Hom-Wang/Quadcopter/Readme.md

Quadcopter
========
* Author      : [Hom](https://github.com/Hom19910422)
* Update      : 2013/12/07
* Description :   
101年的大學專題，專題成果大致可以達到平衡(不太穩)，但尚無法懸停，  
需要更新、更穩定的飛控版本請到 [QCopterFC](https://github.com/Hom19910422/QCopterFlightControl) 下載，這裡將不再做更新。

飛控板
========
* 控制器　STM32F405RG 64Pin 168MHz DSP FPU
* 感測器　L3G4200 + LSM303
* 無線傳輸　nRF24L01P + PA + LNA
* 6個PWM通道　連接電調、LED、PPM
* 1個UART接口　可擴充GPS模組、藍芽模組、電腦傳輸RS232

遙控器
========
* 控制器　STM32F407VG 100Pin 168MHz DSP FPU
* 顯示器　4.3吋螢幕，480*242，SSD1963
* 無線傳輸　nRF24L01P + PA + LNA
* 儲存紀錄　SD卡，使用SDIO操作
* 1個I2C接口　外擴其他裝置
* 1個UART接口　可擴充GPS模組、藍芽模組、電腦傳輸RS232
* DEMO Videos https://www.youtube.com/watch?v=KsObp2a2QdA
<p>
<br />
四軸飛行器<br />

<br /><br />
飛控板<br />

<br /><br />
遙控器正面<br />

<br /><br />
遙控器背面<br />

<br /><br />
螢幕主畫面<br />

<br /><br />
螢幕示波器<br />

<br /><br />
螢幕測試<br />

<br /><br />
<p/>
<br /><span xmlns:dct="http://purl.org/dc/terms/" property="dct:title">Quadcopter</span>由<a xmlns:cc="http://creativecommons.org/ns#" href="https://plus.google.com/u/0/112822505513154783828/posts" property="cc:attributionName" rel="cc:attributionURL">Hom</a>製作，以<a rel="license" href="http://creativecommons.org/licenses/by-sa/3.0/tw/deed.zh_TW">創用CC 姓名標示-相同方式分享 3.0 台灣 授權條款</a>釋出。
