Hom-Wang/Quadcopter/STM32F4_QCopter_20130617/Project_SlaveV2/Readme.txt

/*=====================================================================================================*/
/*=====================================================================================================**
* File Name   : Readme.txt
* Author      : Hom19910422
* Version     : V1.0
* Date        : 2012/09/11
* Description : QCopter Fly Board Software/Hardware Information
**=====================================================================================================*/
/*=====================================================================================================**
* Hardware
*	MCU       : STM32F405VGT
*	SENSOR    : L3G4200, LSM303, BMP085
*	RF        : nRF24L01P+PA+LNA
*	LED       : 8*LED
*	KEY       : 1*SmallButton
*	
*	Add       : uBlox NEO-6M, Bluetooth, OV7670
**=====================================================================================================*/
/*=====================================================================================================**
* Pin Assign
*	PA0		PWM5					*	PB0		PWM3					*	PC0		OV7670_D0
*	PA1		PWM6					*	PB1		PWM4					*	PC1		OV7670_D1
*	PA2		LED6					*	PB2		BOOT_BOOT1				*	PC2		OV7670_D2
*	PA3		LED8					*	PB3		JTAG_JTDO				*	PC3		OV7670_D3
*	PA4		LED3					*	PB4		JTAG_NJTRST				*	PC4		OV7670_D4
*	PA5		KEY						*	PB5		LED4					*	PC5		OV7670_D5
*	PA6		PWM1					*	PB6		I2C1_SCL				*	PC6		OV7670_D6
*	PA7		PWM2					*	PB7		I2C1_SDA				*	PC7		OV7670_D7
*	PA8		LED1					*	PB8		LED7					*	PC8		OV7670_SCL
*	PA9		USART1_Tx				*	PB9		LED5					*	PC9		OV7670_SDA
*	PA10	USART1_Rx				*	PB10	USART3_Tx				*	PC10	OV7670_VSYN
*	PA11	NRF_CE					*	PB11	USART3_Rx				*	PC11	OV7670_WRST
*	PA12	NRF_IRQ					*	PB12	NRF_CSN					*	PC12	OV7670_WEN
*	PA13	JTAG_JTMS				*	PB13	NRF_SCL					*	PC13	OV7670_RRST
*	PA14	JTAG_JTCK				*	PB14	NRF_MISO				*	PC14	OV7670_CS
*	PA15	JTAG_JTDI				*	PB15	NRF_MOSI				*	PC15	OV7670_WR

*	PD2		LED2
**=====================================================================================================*/
/*=====================================================================================================**
* Function : 
*	
**=====================================================================================================*/
/*=====================================================================================================*/
