Hom-Wang/Quadcopter/無人飛行載具_四軸飛行器.pdf

## 無人飛行載具 - 四軸飛行器

王文宏 Wang, Wen-Hung
Hom19910422@gmail.com

摘要－
本專題的主要目的為在單晶片上建立一個可測得載體
當下姿態角度的姿態系統，並通過PD控制器在四軸飛行器 上實現自主平衡與懸停的功能，並藉由自製的平台來做調
整及控制。
專題進行過程首先了解四軸飛行器的結構組成及飛行
原理，再對無線傳輸模組及無刷馬達做控制，以及感測器
讀取與濾波，最後計算飛行器姿態與自主平衡控制。

關鍵字：四軸飛行器、姿態系統、四元數、PID。

1、簡介
近 年 來 ， 由於微機電系統技術 （ Micro Electro Mechanical Systems，MEMS）快速發展與半導體製程工藝 的提升，造就了低成本、普及的感測器，以及高效能的微
控制器，使的以演算法與感測器為核心的四軸飛行器成為
熱門的研究課題，其有重量輕、體積小、結構簡單、機動
性高、維護方便等優點，基於以上優點，可以應用於實時
的監控、地形的探勘、災區的救援以及搜尋、運送等領域
[1]。
目前國內成功大學航太所的飛行控制與模擬實驗室，
研究無人飛行器載具的導航與控制已有數年，並有不錯的
成果，國外美國賓州大學（University of Pennsylvania） GRASP實驗室（The General Robotics, Automation, Sensing and Perception）研究飛行器與飛行器間的協同工作，以及 瑞士蘇黎世聯邦理工學院（ETH Zurich）動態系統與控制研 究所（Institute for Dynamic Systems and Control）的FMA實 驗室（Flying Machine Arena）研究飛行器的學習和安全性， 在學術及實際應用上都有重大的貢獻。

2、結構與飛行原理

2.1、飛行器結構
四軸飛行器結構如圖 1 所示，由兩對正反螺旋槳、四
顆無刷馬達、四個電子調速器（電調）、一顆鋰電池與一片 飛行控制板（飛控板）所組成。

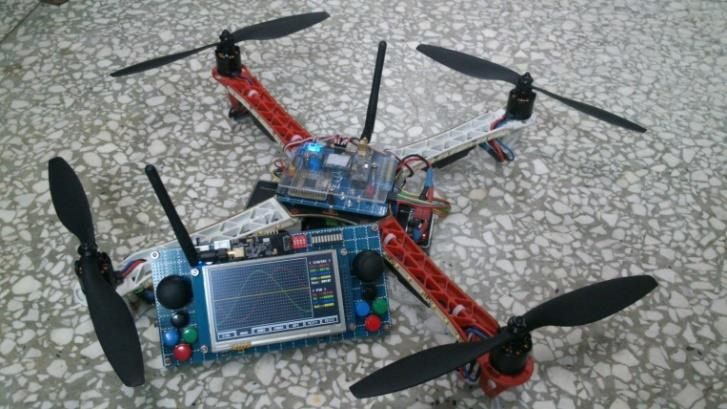
[picture p1: figure]

圖 1 四軸飛行器實體圖
2.1.1、機身
用來放置控制器、馬達、電池以及擴充裝置 … 等等
的平台。機身的大小，會限制螺旋槳的長度，進而影響到
馬達的選擇、飛行器的負載；機身的硬度、材質，會改變
到馬達所產生震動影響的大小。本次專題使用對角馬達與
馬達距離為 450mm 的機身。

2.1.2、螺旋槳
經由馬達帶動旋轉來產生推力以提供飛行器向上升力。
其中螺旋槳依擺放位置分成兩組，兩組旋轉方向互為相反， 達到水平的旋轉力矩平衡。在相同轉速下，螺旋槳越長，
攻角越大，所提供的升力就越大，但所受到的阻力亦會越
大，所以轉動大的螺旋槳需要扭力大的馬達。本次專題使
用 1045 的螺旋槳（長 10cm, 螺距 45），如圖 2 所示。

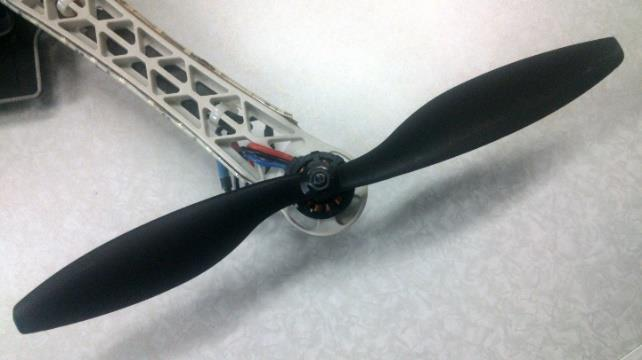
[picture p2: figure]

圖 2 螺旋槳實體圖

2.1.3、無刷馬達
旋轉螺旋槳主要的動力來源，推動飛行器。與有刷馬
達相比，無刷馬達具有扭力大、低耗損的優點，但由於其
結構設計的問題，必須加上一些電路與較為複雜的方法解
決換相問題；線圈的匝數、繞線圈的方法與供電電壓，會
影響到馬達的扭力與轉速，匝數越多間接導致扭力越大、
轉速越低；匝數越少，扭力越小、轉速越快。本次專題使
用 980KV 的無刷馬達（980RPM/V），如圖 3 所示。

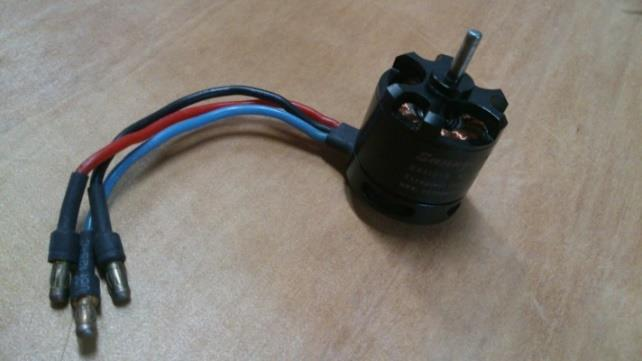
[picture p3: figure]

圖 3 無刷馬達實體圖

2.1.4、電子調速器
藉由此裝置可以簡化無刷馬達的控制，這裡簡稱電調。
電調內已放置了驅動電路與無刷馬達控制程式，只需透過
脈衝寬度調變技術（Pulse Width Modulation, PWM）即可控 制無刷馬達。本次專題使用 40A 的電調，如圖 4 所示。

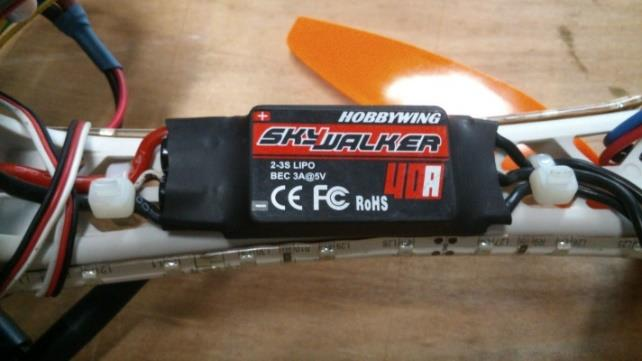
[picture p4: figure]

圖 4 電子調速器實體圖

2.1.5、電池
提供控制板與馬達電源。本專題使用 11.1V 2200mAh 的鋰電池（最大放電 25C, 瞬間 35C），如圖 5 所示。

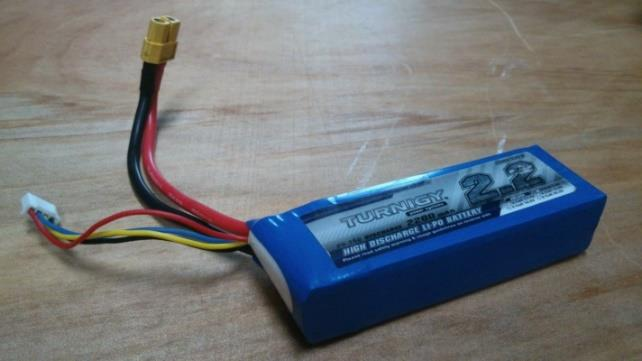
[picture p5: figure]

圖 5 鋰電池實體圖

2.1.6、飛行控制器
控制飛行器平衡運動與傳輸的裝置，這裡簡稱飛控板。
飛控板是集成微控制器、感測器、無線傳輸模組的裝置，
也是非行器的核心裝置，圖 6 為自行設計和製作的飛控版 QCopterFlightControl[2]，以下為配置：
- 微控制器 STM32F405RG
- ARM 32bit Cortex-M4 CPU with FPU
- Frequency up to 168MHz
- 196Kbytes SRAM，1024bytes Flash
- 感測器 SmartIMU[3]
- ARM 32bit Cortex-M4 CPU with FPU
- MPU9250 加速度計、陀螺儀、電子羅盤
- MS5611 氣壓計
- 無線傳輸 nRF24L01P + PA + LNA
- 理想傳輸距離 520m（2Mbps）、750m（1Mbps）、 1000m（250Kbps）
- 儲存紀錄 Micro SD
- SDIO 讀寫
- 其他擴充介面
- 1*USART、1*SPI、2*ADC、1*USB、 1*CAN BUS、8*PWM

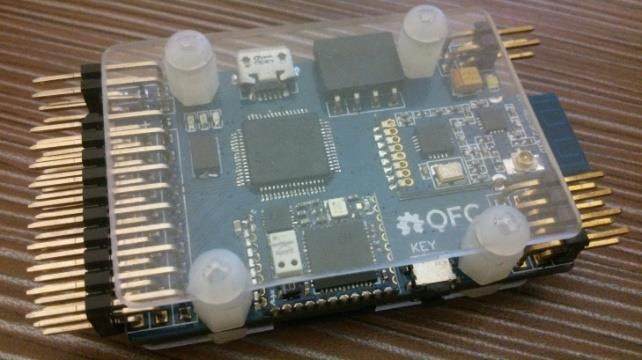
[picture p6: figure]

圖 6 飛行控制器實體圖

2.1.7、遙控器
遙控飛行器、給予飛行器指令與監控訊息的裝置。設
有飛行器基本資訊、示波器和測試 … 等介面，可以檢測 和監控飛行器狀態資訊，如圖 7 為自行設計和製作的遙控 版 QCopterRemoteControl[4]，以下為配置：
- 微控制器 STM32F407VG
- ARM 32bit Cortex-M4 CPU with FPU
- Frequency up to 168MHz
- 196Kbytes SRAM，1024bytes Flash
- 無線傳輸 nRF24L01P + PA + LNA
- 理想傳輸距離 520m（2Mbps）、750m（1Mbps）、 1000m（250Kbps）
- 顯示器 TFT_3.5-inch[5]
- 控制器 R61581
- 3.5 吋螢幕，解析度 480*320
- 色彩 16-bit（RGB 565）
- 儲存紀錄 Micro SD
- SDIO 讀寫
- 其他擴充介面
- 1*USART、1*SPI、1*USB、1*I
2C / CAN BUS

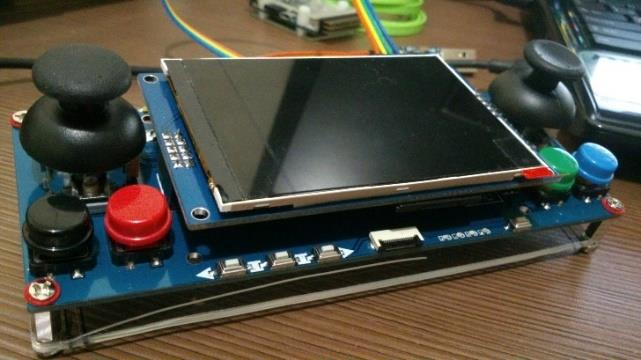
[picture p7: figure]

圖 7 遙控器實體圖

2.2、飛行原理
四軸飛行器的運動原理如圖 8 所示，當升力等於四軸
飛行器自身重量時，飛行器就會保持懸停狀態；在懸停狀
態下增加或減少相鄰兩邊馬達的旋轉速度，則會使四軸飛
行器傾斜，達到移動；若分別增加與減少對角馬達轉速，
則可使飛行器自旋。

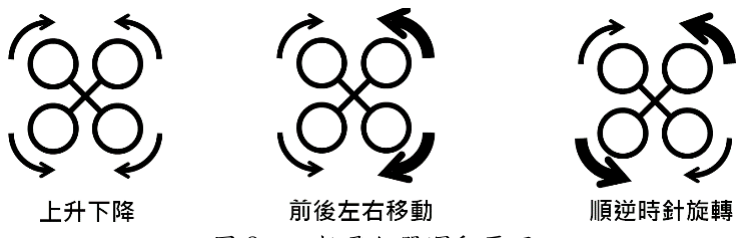
[picture p8: figure]

圖 8 四軸飛行器運動原理

3、系統架構
四軸飛行器的系統運作示意圖如圖 9 所示，微控制器
從感測器讀取資訊，透過演算法計算出飛行器當下姿態角
度作為控制器的回授，姿態角度會經由無線傳輸模組發送
至控制平台做顯示，控制平台則會傳送飛行控制命令資訊
給飛行器，飛行器上的微控制器依此控制命令與飛行器當
下姿態角度的回授，輸入到控制器做計算，控制器輸出
PWM 訊號控制電調，改變無刷馬達轉速，來達到自主平衡 與方向控制。

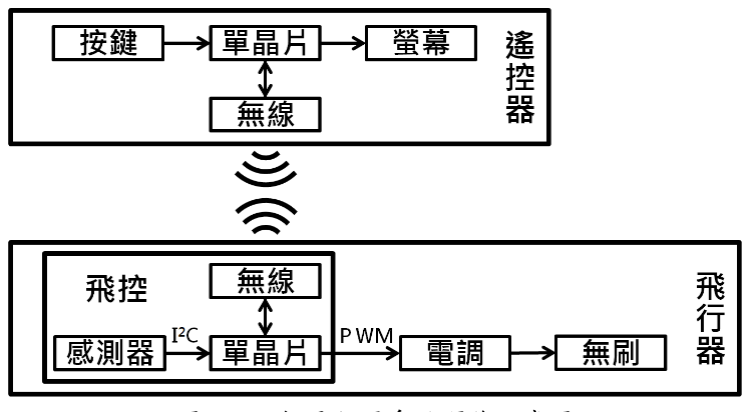
[picture p9: figure]

圖 9 四軸飛行器系統運作示意圖

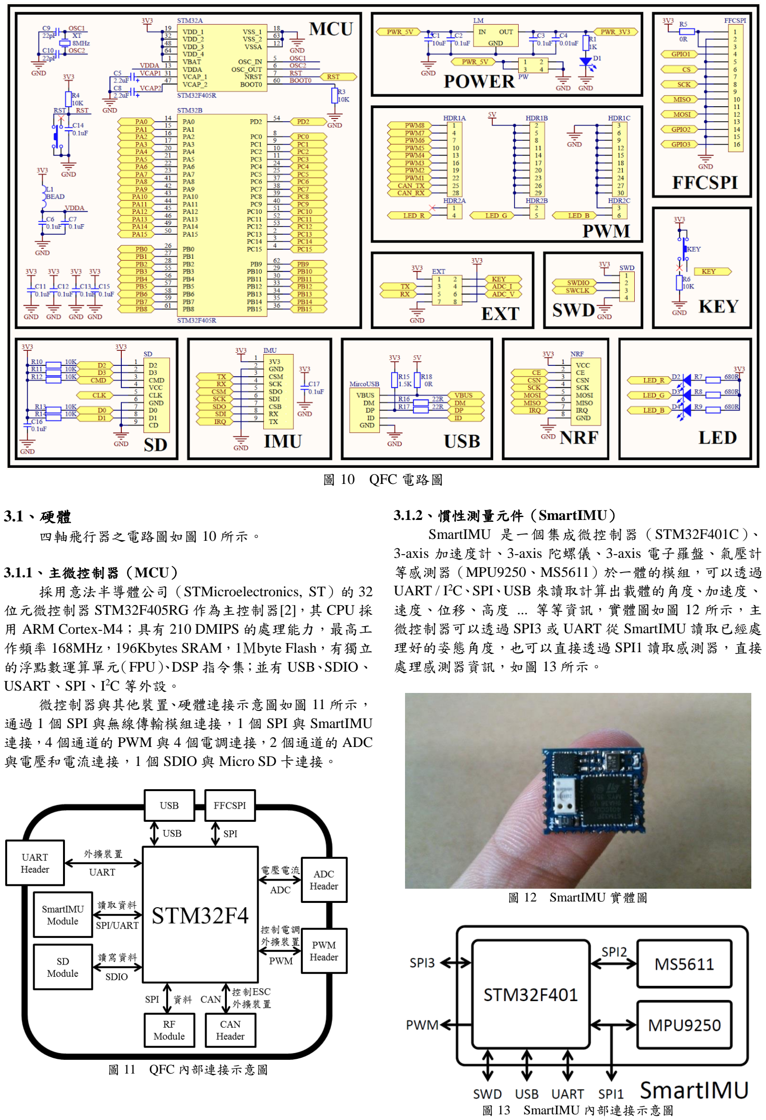
[picture p10: page 3]

圖 10 QFC 電路圖

3.1、硬體
四軸飛行器之電路圖如圖 10 所示。

3.1.1、主微控制器（MCU）
採用意法半導體公司（STMicroelectronics, ST）的 32 位元微控制器 STM32F405RG 作為主控制器[2]，其 CPU 採 用 ARM Cortex-M4；具有 210 DMIPS 的處理能力，最高工 作頻率 168MHz，196Kbytes SRAM，1Ｍbyte Flash，有獨立 的浮點數運算單元（FPU）、DSP 指令集；並有 USB、SDIO、 USART、SPI、I

2C 等外設。
微控制器與其他裝置、硬體連接示意圖如圖 11 所示， 通過 1 個 SPI 與無線傳輸模組連接，1 個 SPI 與 SmartIMU 連接，4 個通道的 PWM 與 4 個電調連接，2 個通道的 ADC 與電壓和電流連接，1 個 SDIO 與 Micro SD 卡連接。

圖 11 QFC 內部連接示意圖

3.1.2、慣性測量元件（SmartIMU）
SmartIMU 是一個集成微控制器（STM32F401C）、 3-axis 加速度計、3-axis 陀螺儀、3-axis 電子羅盤、氣壓計 等感測器（MPU9250、MS5611）於一體的模組，可以透過 UART / I

2C、SPI、USB 來讀取計算出載體的角度、加速度、 速度、位移、高度 ... 等等資訊，實體圖如圖 12 所示，主 微控制器可以透過 SPI3 或 UART 從 SmartIMU 讀取已經處 理好的姿態角度，也可以直接透過 SPI1 讀取感測器，直接 處理感測器資訊，如圖 13 所示。

圖 12 SmartIMU 實體圖

圖 13 SmartIMU 內部連接示意圖

3.1.3、無線傳輸
無線傳輸模組用於向監控平台傳送飛行器上的資訊與
接收控制平台所發送的控制訊號、指令。
本次專題所採用的無線傳輸模組使用 NORDIC 公司 2.4G 的 nRF24L01P，並搭配功率放大器（PA）與低噪音放 大器（LNA）來增加傳輸距離。nRF24L01P 提供了三種傳 輸速率 2Mbps、1Mbps、250Kbps，其空曠下傳輸距離分別 為 520m、750m、1000m。

3.1.4、電源
四軸飛行器的電源供應如圖 14 所示，由 11.1v 2200mAh 的鋰電池作為電力的來源，11.1v 經過 LM2596 轉 換成 5v，再經由 AMS1117 轉換為 3.3v，其中 11.1v 供電給 電調與無刷馬達，5v 供電給其他設備，3.3v 供電給飛控板。

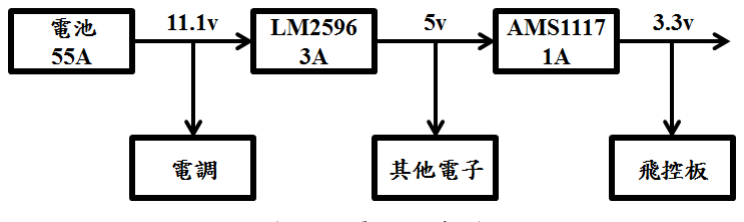
[picture p11: figure]

圖 14 電源供應圖

3.2、軟體
四軸飛行器的程式流程如圖 15 所示，供電後系統首先 對系統時脈、I/O 與各種模組及功能做初始化，再對感測器 做初始校正與飛行器姿態的初始化，最後為防止馬達突然
啟動，設置了鎖定功能，在解鎖前，接收任何訊號皆不會
使馬達旋轉。
解鎖完後即進入有限狀態機（Finite State Machine, FSM），狀態機的狀態如圖 16 所示，狀態機的初始狀態為 接收模式，在此狀態中會接收遙控器的控制訊號，接收成
功後才會進入到下一個狀態發射模式，在發射模式中會將
感測器讀到的資料與計算的姿態傳送到遙控器顯示，傳送
完後就進入下一個狀態控制模式，在控制模式中會使用平
台所傳來的控制資訊，對四軸飛行器做控制，目前只有控
制飛行器的傾斜角度與馬達轉速大小，控制完後就進入串
列模式，這個狀態是用來測試與外接其他功能用的，以增
加擴充性。

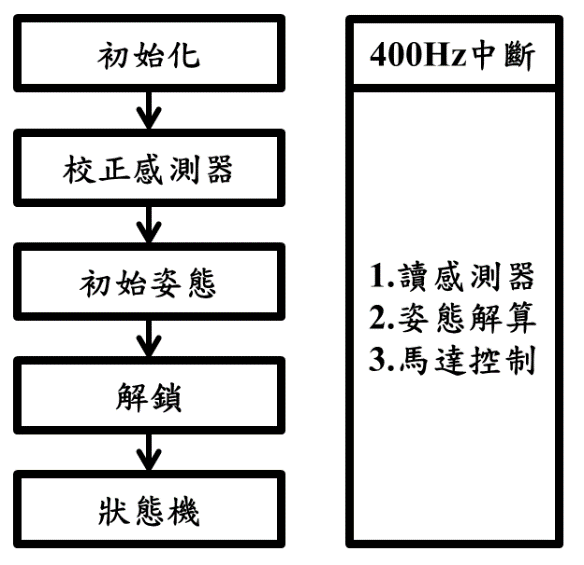
[picture p12: figure]

圖 15 程式流程圖

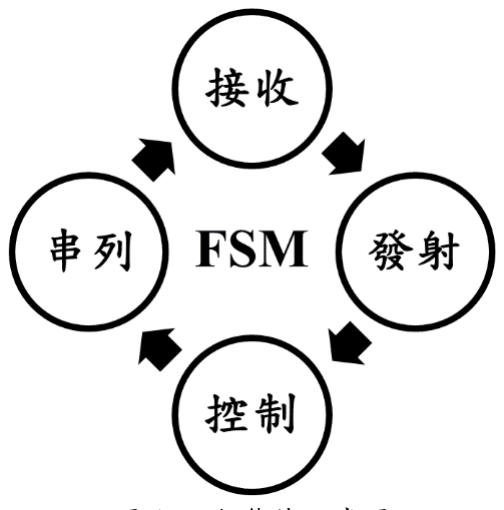
[picture p13: figure]

圖 16 狀態機示意圖

4、演算法
演算法為四軸飛行器之核心，其中主要包含了感測器
的校正、姿態的計算與平衡的控制，本次專題中主要的演
算法實現於 400Hz 的計時中斷中，其流程如圖 17 所示。 一開始先讀取感測器資料，然後利用初始校正所得到
的校正資訊對讀到的資料作校正，校正完後轉成物理量（mg、 dps、gauss），再對其做加權移動平均，減少誤差，最後計 算飛行器姿態，並依此當前的姿態做 PID 平衡，以達到自 主懸停及控制。

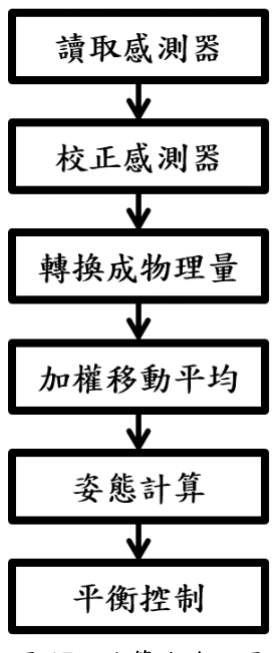
[picture p14: figure]

圖 17 演算法流程圖

4.1、初始校正
MEMS 元件雖然具有體積小與低成本的優勢，但只要
是感測器都會有誤差存在的問題。

4.1.1、加速度計校正
考慮到地球上相同地區的重力加速度誤差可視為零的
情況下，預先測量在水平狀態下的加速度與重力加速度
g (0, 1, 1) 的誤差並記錄，在程式中就不需再次測量，直接 對加速度計誤差的做偏移校正。

4.1.2、陀螺儀校正
陀螺儀為測量角速度的元件，已知靜止無運動的情況
下，角速度為零，利用此條件對陀螺儀做校正，實際方法： 先讓飛行器保持靜止，此時讀取陀螺儀 100 筆數據求平均 值，此平均值則為陀螺儀的誤差偏移量，之後每次讀取完
後減去此平均值即可得到正確的數據。

4.1.3、電子羅盤校正
地球磁場並非是均勻分佈的，會存在磁傾角及磁偏角，
以台灣為例，磁傾角約為 37 度左右，加上馬達、環境、電 池…等的影響干擾，在不校正的情況下，難以取的正確的
航向。
只考慮二維的情況下，電子羅盤的 X 軸 Y 軸所讀到的 磁場理想上會以中心在原點上的圓形所分佈，但受到其他
磁場的影響會使圓形變形且偏離原心，造成磁場以橢圓形
分佈。
對電子羅盤間隔 45 度做一次取樣，共有 8 點的磁場樣 本，在對樣本做橢圓擬合[5]，得出橢圓方程後，將橢圓移 到原心，並還原成圓形，使航向可以正常取得，詳細過程
請參考附件 1。

4.2、姿態計算
直接對角速度做積分是取得姿態的方法之一，但由於
陀螺儀本身的誤差會隨溫度變化，長時間對角速度做積分
等同於放大誤差，加上角速度所計算出來的角度其中有一
為 90 度或 270 度時，轉回原始座標時就會產生萬向節鎖 （Gimbal Lock）的問題，導致轉不回去，所以專題在姿態 計算中採用四元數[6]，並使用文獻[7]的方法實現。 在航向角部分採用互補濾波（Complementary Filter, CF），依文獻[8]之方法，套用至基於電子羅盤的航向角確定， 將電子羅盤靜態時精確及陀螺儀的高靈敏度的特性結合在
一起，以取得準確的航向。

4.2.1、四元數
四元數可以有效解決萬向節鎖問題，且經過一些變換
後，可以直接以角速度來更新姿態與使用加速度計來校正
陀螺儀。
利用四元數將地理的重力加速度旋轉至飛行器上面，
再與加速度計讀出的值（已歸一化的）做外積，得出誤差， 用此誤差對角速度做校正融合，詳細過程請參考附件 2。

4.2.2、互補濾波
將電子羅盤長期準確及陀螺儀靈敏度高的特性互補，
即為對電子羅盤做低通濾波，對陀螺儀做高通濾波，並將
其相加，得出較為可信的資訊。

Angle = (k) ∗ (Angle + Gyro ∗ dt) +(1 −k) ∗ AngleMag

其中k 是高低通頻率邊界，k = 時間常數 τ/(時間常數 τ+ 取樣時間 dt)，AngleMag 是透過電子羅盤計算出來的航向 角度。

4.3、平衡控制
PID 控制器在控制領域上已有數十年的發展，其特點
簡單、穩定和有效，使他至今仍然廣為使用，本專題在自
主平衡方面選用 PD 控制器，輸入期望角度及當前三軸角度 以及角速度至 PD 控制器，將計算出來的三軸結果，依螺旋 槳旋轉的方向分配至四顆馬達上，來達到對四軸平衡的效
果，控制器設計如下：

u(t) = KP ∗ e(t) + KD ∗ ω(t)

上式中 u(t) 是 PD 控制器的輸出，KP 與 KD 是控制器參 數，e(t) 是回授角度與期望角度的誤差，ω(t) 是角速度。

5、結果與討論
以 400Hz 的取樣及更新週期，在沒有啟動馬達的情況 下，姿態角的誤差可以達到 0.2 度以內，在起動馬達後，因 為馬達的震動，使角度會在 5 度內震盪，使用 PID 控制器 雖然可以讓飛行器飛起來，但卻沒辦法非常穩定的平衡，
所以目前設計的計算姿態方法還需再調整及改善，以達到
穩定的平衡，圖 18 至圖 25 為起飛時每隔 0.2 秒所拍攝的實 際影像。
圖26為加速度的整體數據，縱軸單位為加速度（mg）， 橫軸單位為數據數，啟動馬達後加速度計的XY軸約在±0.3g 跳動，而 Z 軸約±0.2g 跳動。
圖 27 為陀螺儀的整體數據，縱軸單位為角速度
（10mdps），橫軸單位為數據數，啟動馬達後陀螺儀的 X 軸 約±40dps 跳動，Y 軸約±100dps 跳動，而 Z 軸約±10dps 跳 動。
圖 28 為電子羅盤的整體數據，縱軸單位為高斯
（0.1mGauss），橫軸單位為數據數，啟動馬達後電子羅盤 震動都還不算太大，但出現了明顯的磁場變化，X 軸約減 少了 20mGauss，Y 軸約減少了 60mGauss，而 Z 軸約減少 了 70mGauss。
圖 29 為計算出來的角度數據，縱軸單位為角度（XY 軸 10mdeg，Z 軸 100mdeg），橫軸單位為數據數，啟動馬達 後角度的 X 軸約±4deg 跳動，Y 軸約±2deg 跳動，而 Z 軸幾 乎沒有明顯震動，反倒是偏移了 10deg。

6、參考文獻
[1] 維基百科，四軸飛行器
http://zh.wikipedia.org/wiki/%E5%9B%9B%E8%BD%B 4%E9%A3%9E%E8%A1%8C%E5%99%A8 (http://zh.wikipedia.org/wiki/%E5%9B%9B%E8%BD%B4%E9%A3%9E%E8%A1%8C%E5%99%A8)
[2] QCopterFlightControl, GitHub https://github.com/QCopter/QCopterFlightControl
[3] SmartIMU, GitHub
https://github.com/Hom-Wang/SmartIMU
[4] QCopterRemoteControl, GitHub https://github.com/QCopter/QCopterRemoteControl
[5] 陳基偉，橢圓直接擬合算法研究，工程勘察，2007
[6] 鄭正隆，慣性技術 Inertial Technology，崧博出版事業 有限公司，2011
[7] M. Euston, P. Coote, R. Mahony, Jonghyuk Kim and T. Hamel, “A Complementary Filter for Attitude Estimation of a Fixed-Wing UAV,” IEEE International Conference on Intelligent Robots and Systems, pp. 340-345, Sept. 2008.
[8] Shane Colton, “The Balance Filter,” Massachusetts Institute of Technology, Tech. Rep., 2007

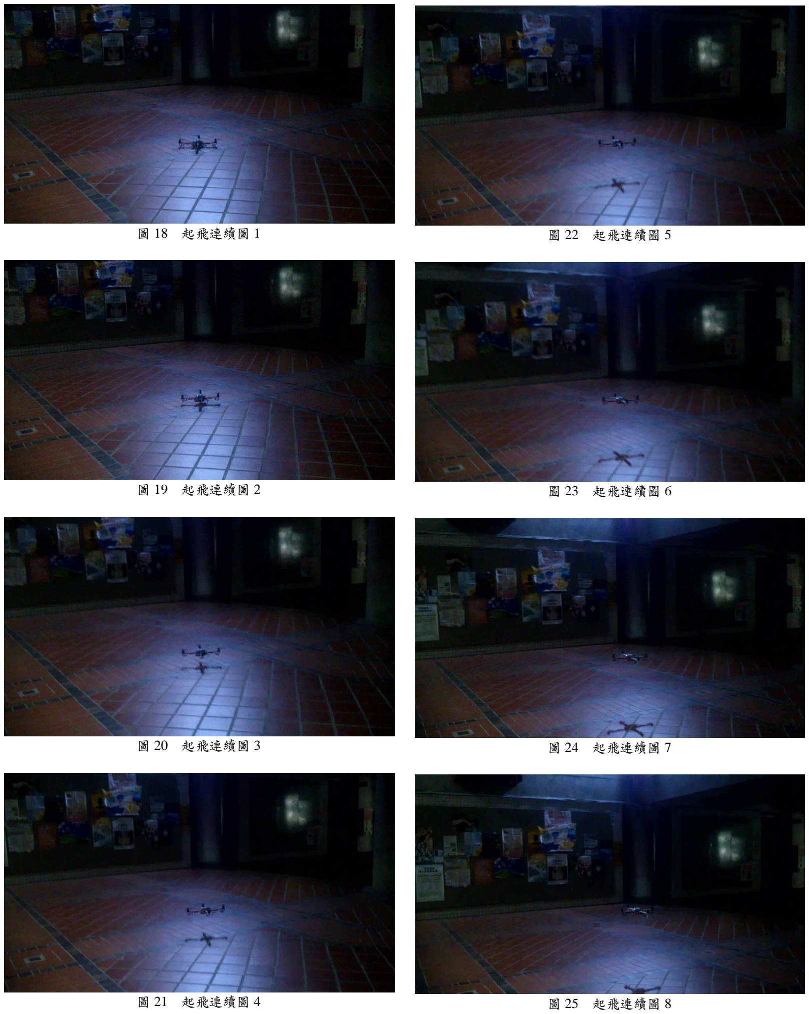
[picture p15: page 6]

圖 18 起飛連續圖 1

圖 19 起飛連續圖 2

圖 20 起飛連續圖 3

圖 21 起飛連續圖 4

圖 22 起飛連續圖 5

圖 23 起飛連續圖 6

圖 24 起飛連續圖 7

圖 25 起飛連續圖 8

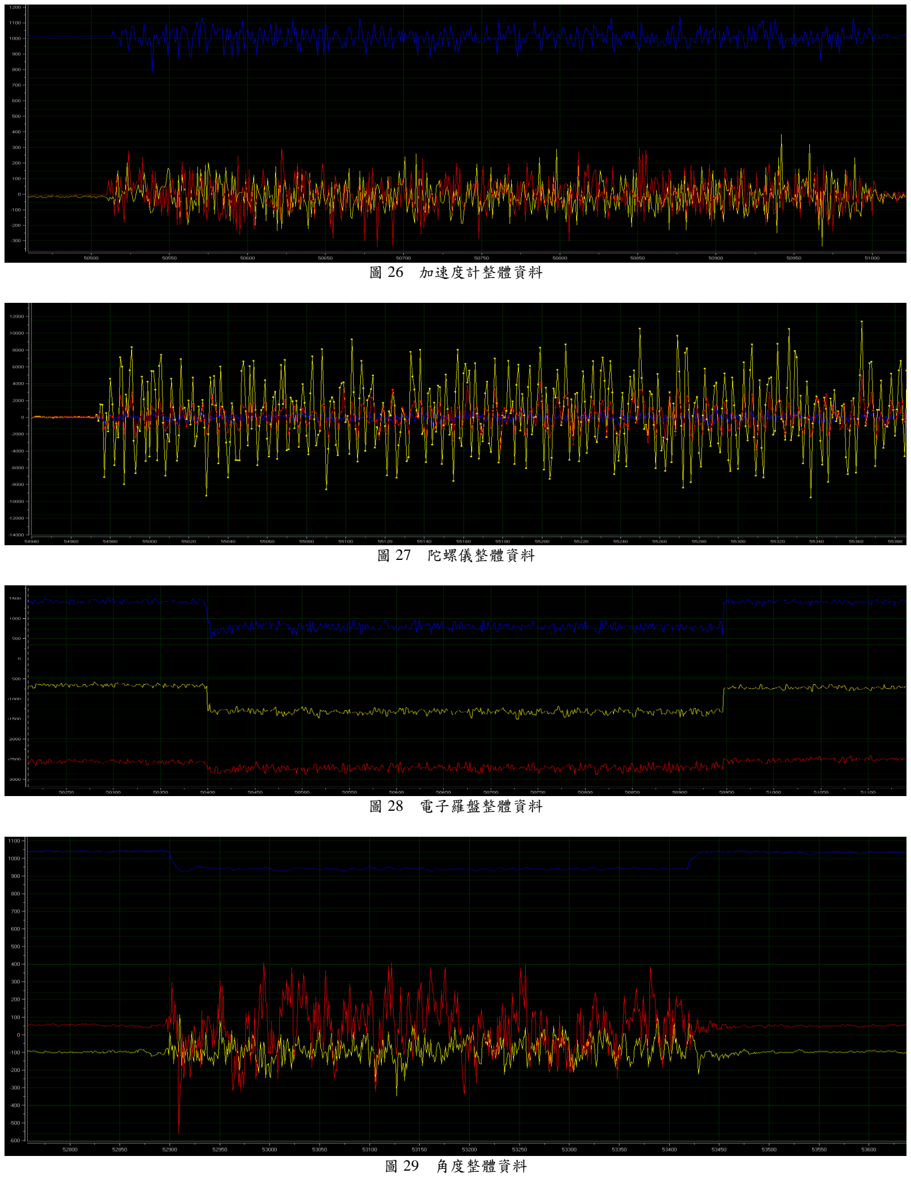
[picture p16: page 7]

圖 26 加速度計整體資料

圖 27 陀螺儀整體資料

圖 28 電子羅盤整體資料

圖 29 角度整體資料

附件 1、橢圓擬合

任意位置大小的橢圓方程式可以描述如下：
(

X −X0
a

)

2
+(

Y − Y0
b

)

2
= 1

上式可分解成圓形對 X, Y 軸做變形
{

(

X − X0
Y − Y0

) = (

a 0
0 b

) (

X′
Y′

)

(X′)

2 +(Y′)

2 = 1

對 X, Y 軸做旋轉
{

(

X −X0
Y −Y0

) = (

cosθ sinθ
−sinθ cosθ

) (

a 0
0 b

) (

X′
Y′

)

(X′)

2 +(Y′)

| 2 = 1

求得 X

′
, Y′
(

X

′
Y

′

) = (

a ∗ cosθ b ∗ sinθ
−a ∗ sinθ b ∗ cosθ)

−1
(

X − X0
Y − Y0

)

⟹ (

X

′
Y

′

) = (

cosθ
a

−

cosθ
a

·

sinθ
Cos[θ]
cosθ
b

·

sinθ
cosθ

cosθ
b

) (
X − X0
Y − Y0

)

令 α =

cosθ
a

, β =

cosθ
b

, γ = tanθ

⟹ (

X

′
Y

′

) = (

α | −α · γ
β · γ | β

) (

X − X0
Y − Y0

) = (

α(X −X0

)− αγ(Y − Y0)
βγ(X − X0

)+ β(Y − Y0)

)

代入圓形方程&整理

(α(X − X0

)− αγ(Y − Y0

))

2 + (βγ(X − X0
)+β(Y − Y0

))

2 = 1

⟹ (α

2 + β

2γ

2
)(X − X0

)

2 +2(β

2γ − α

2γ)(X −X0
)(Y −Y0

)+ (α

2γ

2 + β

2
)(Y − Y0

)

2 = 1

令 U = α

2 + β

2γ

2
, V = 2(β

2γ − α

2γ), W = α

2γ

2 + β

2

(U)X

2 + (V)XY + (W)Y

2 + (−2UX0 −VY0
)X + (−VX0 − 2WY0

)Y +(UX0

2 + VX0Y0 + WY0

2
) = 1

⟹ X

2 + (

V
U

) XY + (

W
U

) Y

2 +(

−2UX0 − VY0
U

)X + (

−VX0 − 2WY0
U

) Y + (
UX0

2 + VX0Y0 + WY0

2
U

) = 1

⟹ X

2 + (

V
U

) XY + (

W
U

) Y

2 + (−2X0 −

V
U

Y0) X + (−

V
U

X0 −2

W
U

Y0) Y + (X0
2 +

V
U

X0Y0 +

W
U

Y0

2

) =

1
U

任意橢圓方程式

X

2 + A · XY + B · Y

2 + C · X + D · Y + E = 0

其中 A =

V
U

, B =

W
U

, C = −2X0 − AY0

, D = −AX0 −2BY0

, E = X0

2 + AX0Y0 + BY0

2 −

1
U

使用最小平方法做橢圓擬合, 其中 N 為取樣數目

Q = ∑Fi
2

N

i=1

= ∑(Xi
2 +A · XiYi +B · Yi

2 + C · Xi + D · Yi +E)
2

N

i=1

欲使 Q 為最小值, 必有

∂Q
∂A =

∂Q
∂B =

∂Q
∂C =

∂Q
∂D =

∂Q
∂E = 0

展開

∂Q
∂A = 2∑(Xi
2 + A · XiYi + B · Yi

2 + C · Xi + D · Yi + E)(XiYi )

N

i=1

= 0

∂Q
∂B

= 2∑(Xi
2 + A · XiYi + B · Yi

2 +C · Xi + D · Yi + E)(Yi

2
)

N

i=1

= 0

∂Q
∂C

= 2∑(Xi
2 + A · XiYi + B · Yi

2 + C · Xi +D · Yi + E)(Xi) = 0

N

i=1

∂Q
∂D

= 2∑(Xi
2 + A · XiYi + B · Yi

2 +C · Xi + D · Yi + E)(Yi)

N

i=1

= 0

∂Q
∂E

= 2∑(Xi
2 +A · XiYi + B · Yi

2 + C · Xi + D · Yi +E)(1) = 0

N

i=1

矩陣形式

(

∑Xi
2Yi

2

N

i=1

∑XiYi
3

N

i=1

∑Xi
2Yi

N

i=1

∑XiYi
2

N

i=1

∑XiYi

N

i=1
∑XiYi
3

N

i=1

∑Yi
4

N

i=1

∑XiYi
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
∑XiYi
2

N

i=1

∑Xi
2

N

i=1

∑XiYi

N

i=1

∑Xi

N

i=1
∑XiYi
2

N

i=1

∑Yi
3

N

i=1

∑XiYi

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
∑XiYi

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
i=1 | )

解線性方程組後, 可得到 A, B, C,D, E 的值

由 C = −2X0 − AY0

, D = −AX0 − 2BY0 , 可解得 X0 , Y0

X0 =

2BC − AD
A² − 4B

, Y0 =

2D −AC
A² − 4B

由 U = α

2 + β

2γ

2
, V = 2(β

2γ − α

2γ), W = α

2γ

2 + β

2 , 可解得 γ, θ

W − U
V

=

| 1− γ
| 2
| 2γ

⟹ Vγ² + 2(W − U)γ − V = 0

⟹ Aγ

2 + 2(B − 1)γ − A = 0

γ =

1 − B
A

± √(
1 − B
A

)

2 + 1

θ = ArcTan[γ]

由 E = X0

2 + AX0Y0 + BY0

2 −

1
U

, 可解得 U

U =

1
(X0

2 +AX0Y0 +BY0

2
)− E

由 U = α

2 + β

2γ

2
, V = 2(β

2γ − α

2γ) , 可解得 a, b

α = √
U
γ

4 − 1

(Bγ

2 − 1), β = √
U
| γ

4 − 1

(γ

2 − B)

⟹ a =

Cos[θ]
α

, b =

Cos[θ]
β

整理結果

{

X0 =

2BC − AD
A² − 4B

Y0 =

2D − AC
A² − 4B
θ = ArcTan[γ]

a =

Cos[θ]
√
U
γ

4 −1

(Bγ

2 − 1)

b =

Cos[θ]
√
U
γ

4 − 1

(γ

2 −B)

U =

1
(X0

2 + AX0Y0 +BY0

2
)− E

γ =

1− B
A

± √(
1 − B
A

)

2
+1

附件 2、四元數

### 1. 方向餘弦矩陣 DCM

先建立旋轉矩陣 Rx, Ry, Rz，繞 X, Y, Z 軸旋轉角度分別為 θ, ϕ, ψ

Rx = (

1 | 0 | 0
0 | cosθ | sinθ
0 −sinθ cosθ

) , Ry = (

cosφ 0 −sinφ
0 | 1 | 0
sinφ 0 | cosφ ) , | Rz = (
cosψ | sinψ 0
−sinψ cosψ 0
0 | 0 | 1

)

設一向量 P(X, Y, Z)，並依 Z − Y − X 順序對向量旋轉，對 Z 軸旋轉，P

′ 為 P 對 Z 軸旋轉後的向量

P

′ = Rz
- P

對 Y 軸旋轉，P

′′為 P

′ 對 Y 軸旋轉後的向量

P

′′ = Ry · P′ = Ry · Rz
- P

對 X 軸旋轉，P

′′′ 為 P

′′ 對 X 軸旋轉後的向量

P

′′′ = Rx · P

′′ = Rx · Ry · Rz
- P

令 Rxyz = Rx · Ry · Rz, 則

Rxyz = (

cosφ cosψ | cosφ sinψ | −sinφ
cosψ sinθ sinφ − cosθ sinψ | cosθ cosψ + sinθ sinφ sinψ | cosφ sinθ

cosθ cosψ sinφ +sinθ sinψ −cosψ sinθ + cosθ sinφ sinψ cosθ cosφ)

### 2. 四元數 Quaternions

四元數由一個實數與三個虛數組成，可表示成

Q = q0 +q1

i

^
+ q2

j

^
+ q3 k

^
= cos

θ
2

+ n

^
- sin

θ
2

其中 n

^ 為轉軸方向, θ⁄2為轉角大小，i

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
= −1, i

^
- j

^
= −j

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
= −k

^
- j

^
= i

^
, k

^
- î= −i

^
- k

^
= j

^

設有兩四元數 QA, QB，其乘法關係為

Q = QA · QB = (qA0 + qA1
i

^
+ qA2

j

^
+qA3 k̂) · (qB0 +qB1
i

^
+qB2

j

^
+ qB3 k

^
)

= (

qA0

- qB0 −qA1
- qB1 −qA2
- qB2 − qA3
- qB3
qA1
- qB0 +qA0
- qB1 −qA3
- qB2 + qA2
- qB3
qA2
- qB0 +qA3
- qB1 +qA0
- qB2 − qA1
- qB3
qA3
- qB0 −qA2
- qB1 −qA1
- qB2 + qA0
- qB3

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
旋轉四元數

Qxyz = Qz

- Qy · Qx = (cos

ψ
2

+ sin

ψ
2

k

^
) · (cos

φ
2

+ sin

φ
2

j

^
) · (cos

θ
2

+sin

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
+ sin

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
− sin

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
+ sin

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
− cos

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
設一向量 R = xi

^
+ yj

^
+ zk

^
，及旋轉後向量 R′ = x′i

^
+ y′j

^
+ z′k

^
，四元數滿足 R′ = Q

−1
- R · Q

四元數倒數

Q

−1 =

1
Q

=

Q

∗
Q · Q∗ =

Q

∗
❘Q❘

當四元數被歸一化後

❘Q❘ = 1 ⇒ Q

−1 = Q

∗

可得到

R′ = Q

∗
- R · Q

將其展開

x′i

^
+ y′j

^
+ z′k

^
= (q0 −q1

i

^
− q2

j

^
− q3k

^
) · (xi

^
+ yj

^
+ zk

^
) · (q0 +q1

i

^
+ q2

j

^
+ q3k

^
)

⇒ (

x′
y′
z′

) = (
q0

2 + q1

2 − q2

2 − q3

2 2(q1
- q2 + q0
- q3

) 2(q1
- q3 − q0
- q2

)
2(q1
- q2 − q0
- q3

) q0

2 − q1

2 + q2

2 − q3

2 2(q2
- q3 + q0
- q1

)
2(q1
- q3 + q0
- q2

) 2(q2
- q3 − q0
- q1

) q0

2 − q1

2 − q2

2 + q3

2

) · (
x
y
z

)

令四元數旋轉矩陣為 Mq

Mq = (

M11 | M12 | M13
M21 | M22 | M23
M31 | M32 | M33

) = (
q0

2 +q1

2 − q2

2 − q3

2 2(q1
- q2 + q0
- q3

) 2(q1
- q3 − q0
- q2

)
2(q1
- q2 − q0
- q3

) q0

2 −q1

2 + q2

2 − q3

2 2(q2
- q3 + q0
- q1

)
2(q1
- q3 + q0
- q2

) 2(q2
- q3 − q0
- q1

) q0

2 − q1

2 − q2

2 + q3

2

)

將 Qxyz 帶入 Mq 會得到與 Rxyz 相同結果

Mq = (

M11 | M12 | M13
M21 | M22 | M23
M31 | M32 | M33

) = (

cosφ cosψ | cosφ sinψ | −sinφ
cosψ sinθ sinφ − cosθ sinψ | cosθ cosψ + sinθ sinφ sinψ | cosφ sinθ

cosθ cosψ sinφ + sinθ sinψ −cosψ sinθ +cosθ sinφ sinψ cosθ cosφ)

將尤拉角轉成四元數, 由 Mq 可得出

θ = tan

−1

(

M23
M33
) , | φ = −sin⁻¹
(M13), | ψ = tan⁻¹

(

M12
M11

)

### 3. 四元數微分

四元數微分，已知一四元數 Q = cos

θ
2

+ n

^
- sin θ
2

，對時間微分

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
- sin

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
已知 n

^
- n

^
= −1,

ⅆn

^

ⅆt

= 0,

ⅆθ
ⅆt

= ωEb

E
, E 為地理座標系, b 為飛行器坐標系

ⅆQ
ⅆt

=

1
2

n

^
- ωEb

E
- (cos

θ
2

+ n

^
- sin

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
因為陀螺儀在飛行器上測到的角速度為 ω

⇀
Eb

b = ωxi

^
+ ωyj

^
+ωzk

^
, 故將 ω

⇀
Eb

E 轉換成 ω

⇀
Eb

b 會較為方便

ω

⇀
Eb

b = Q
∗ω

⇀
Eb

E
- Q ⇒ Q · ω

⇀
Eb

b = Q · Q
∗
- ω

⇀
Eb

E
- Q = ω

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
- Q =

1
2

Q · ω

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
Q · ω

⇀
Eb

b 展開

ⅆQ
ⅆt

=

1
2

(q0 +q1

i

^
+ q2

j

^
+ q3k

^
) · (ωxi

^
+ ωyj

^
+ ωzk

^
) =

1
2
(
0 | −ωx | −ωy | −ωz
ωx | 0 | ωz | −ωy
ωy | −ωz | 0 | ωx
ωz | ωy | −ωx | 0

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
= Ωb · Q

其中

Ωb =

1
2
(
0 | −ωx | −ωy | −ωz
ωx | 0 | ωz | −ωy
ωy | −ωz | 0 | ωx
ωz | ωy | −ωx | 0

)

### 4. 更新四元數

使用一階 Runge-Kutta 更新四元數, 假設有一微分方程

ⅆX
ⅆt

= f[X[t], ω[t]]

則其解為

X[t + Δt] = X[t] + Δt · f[X[t], ω[t]]

其中 Δt 為取樣週期, 將套用至四元數

Q[t +Δt] = Q[t] +Δt · Ωb

[t] · Q[t]

展開上式
(

q0
q1
q2
q3

)

t+Δt

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
−ωx · q1 − ωy · q2 −ωz

- q3
+ωx · q0 − ωy · q3 +ωz
- q2
+ωx · q3 + ωy · q0 −ωz
- q1
−ωx · q2 + ωy · q1 +ωz
- q0

)

只需利用角速度即可更新四元數

### 5. 使用四元數融合加速度計

利用四元數將地理的重力加速度旋轉至飛行器上面，再與加速度計讀出的值（已歸一化的）做外積，得出誤差，用此誤 差對角速度做校正融合，假設一重力加速度

g

⇀
= gz

^

做歸一化後

g

⇀
→ g

^
= z

^

設旋轉至飛行器上的重力加速度為 g

^
b

g

^
b = Mq · g

^

= (

M11 | M12 | M13
M21 | M22 | M23
M31 | M32 | M33

) · (

0
0/1)

⇒ g

^

b = (

gbx
gby
gbz

) = (

M13
M23
M33

)

飛行器上的加速度計測得的加速度 a

⇀
b 做歸一化

a

⇀
b → a

^
b

做外積, 計算誤差 e

⇀

e

⇀
= a

^
b × g

^

b = |
x

^
y

^
z

^
abx | aby | abz
gbx | gby | gbz| = |
aby | abz
gby | gbz

| x

^
+ |
abz | abx
gbz | gbx

| y

^
+ |
abx | aby
gbx | gby

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
) = (

aby · gbz − abz · gby
abz · gbx − abx · gbz

abx · gby − aby · gbx)

將 e 融合至角速度上
