Hom-Wang/Quadcopter/四軸飛行器_專題報告.pdf

## 101 學年度中原大學電機系專題製作成果報告論文 四軸飛行器

學生姓名(學號)：王文宏(9812115)
指導老師：邱謙松 副教授

摘要 —
本專題的主要目的為在單晶片上建立一個可測得載
體當下姿態角度的姿態系統，並通過 PID 控制器在四軸 飛行器上實現自主平衡與懸停的功能，並藉由自製的監
控平台來做調整及控制。
專題進行過程首先了解四軸飛行器的結構組成及飛
行原理，再對無線傳輸模組及無刷馬達做控制，以及感
測器讀取與濾波，最後計算飛行器姿態與自主平衡控
制。

關鍵詞：四軸飛行器、姿態系統、四元數、PID。

1、簡介

近年來，由於微機電系統(Micro Electro Mechanical Systems，MEMS)技術快速發展，造就了低成本、普及 的感測器，使的以演算法與感測器為核心的四軸飛行器
成為熱門的研究課題，其有著重量輕、體積小、結構簡
單、機動性高、維護方便等優點。
國內成大航太所的＂飛行控制與模擬實驗室＂研究
無人飛行器載具的導航與控制已有數年，國外賓州大學
(University of Pennsylvania) 的 GRASP 實驗室 (The General Robotics, Automation, Sensing and Perception)研 究飛行器與飛行器間的協同工作。
四軸飛行器基於以上優點，可以應用於實時監控、
地形探勘、災區救援及收尋[1]。

2、結構與飛行模式

2.1、飛行器結構
四軸飛行器的結構如圖一所示，由兩對正反槳、四
顆無刷馬達、四個電子調速器(電調)、一顆電池、飛行
控制板(飛控板)所組成。

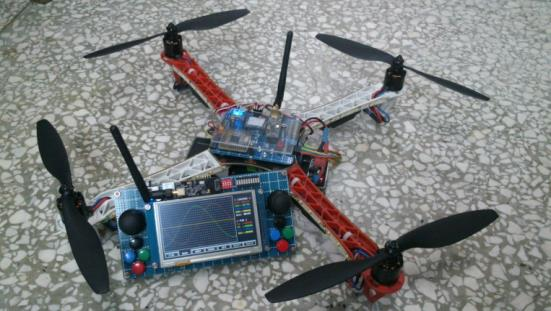
[picture p17: figure]

圖一 四軸飛行器整體圖

2.1.1、機身
用來放置控制器、馬達、電池…等等的平台。機身
的大小，會限制螺旋槳的長度，進而影響到負載的大
小；機身的硬度，會使感測器受到馬達所產生震動影響
的大小。本次專題使用對角長度 450mm 的機身。

2.1.2、螺旋槳
經由馬達旋轉來產生升力，以推動飛行器。其中螺
旋槳依對角分成兩組，兩組旋轉方向為相反，以達到水
平的旋轉力矩平衡。在相同轉速下，螺旋槳越長，攻角
越大，所提供的升力就越大，但所受到的阻力亦會越
大，所以轉動大的槳需要扭力大的馬達。本次專題使用
1045 的螺旋槳(長 10cm, 螺距 45) ， 如圖二所示。

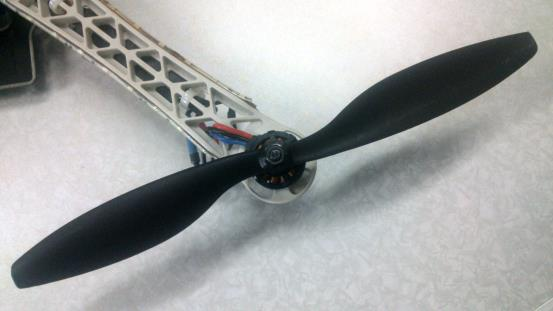
[picture p18: figure]

圖二 螺旋槳實體圖

2.1.3、無刷馬達
旋轉螺旋槳來提供升力，以推動飛行器。與有刷馬
達相比，無刷馬達具有扭力大、低耗損的優點，但由於
其結構，必須加上一些電路與較為複雜的方法控制(換
相)，線圈的匝數，會影響到馬達的扭力與轉速，匝數越
多扭力越大、轉速越低；匝數越少，扭力越小、轉速越
快。本次專題使用 980KV 的無刷馬達(980RPM/V) ， 如 圖三所示。

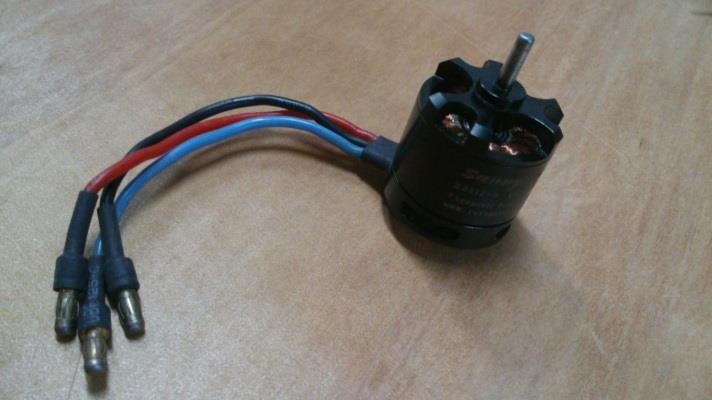
[picture p19: figure]

圖三 無刷馬達實體圖

2.1.4、電子調速器
藉由此裝置可以簡化無刷馬達的控制，這裡簡稱電
調。電調內已放置了驅動電路與無刷馬達控制程式，只
需輸入 PWM 即可控制無刷馬達。本次專題使用 40A 的 電調，如圖四所示。

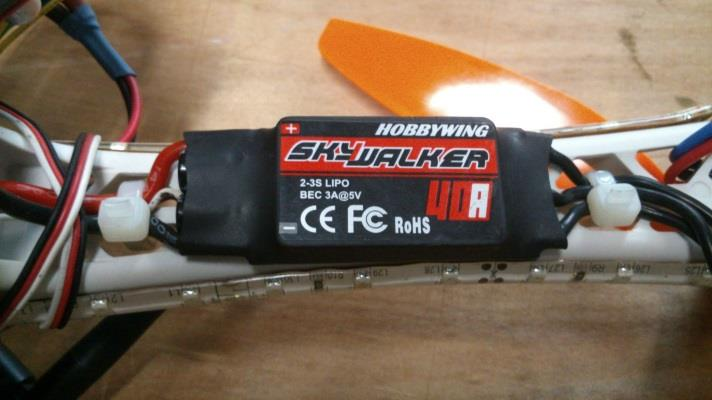
[picture p20: figure]

圖四 電子調速器實體圖

2.1.5、電池
提供控制板與馬達電源。本次專題使用 11.1V
2200mAh 的鋰電池(最大放電 25C, 瞬間 35C) ， 如圖五 所示。

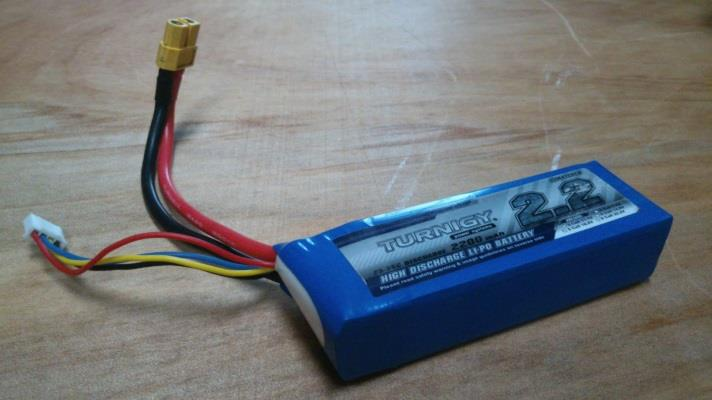
[picture p21: figure]

圖五 鋰電池實體圖

2.1.6、飛行控制器
控制飛行器平衡運動與傳輸的裝置，這裡簡稱飛控
板。飛控板是集成微控制器、感測器、無線傳輸模組的
裝置，如圖六所示。以下為配置：

‧微控制器 STM32F405RGT
ARM 32bit Cortex-M4 CPU with FPU
Frequency up to 168MHz
196Kbytes SRAM，1024bytes Flash

‧無線模組 nRF24L01+PA+LNA
使用 SPI 傳輸( Max 10MHz )
空曠下的理想傳輸距離及速率
520m(2Mbps)/750m(1Mbps)/1000m (250Kbps) ‧陀螺儀 L3G4200D
使用 I

2C 傳輸( Max 400KHz )
角速度量程 ± 250/500/2000 dps

‧加速度計+電子羅盤 LSM303DLM
使用 I

2C 傳輸( Max 400KHz )
加速度量程 ± 2/4/8 g
磁力量程 ± 1.3/1.9/2.5/4.0/4.7/5.6/8.1 gauss

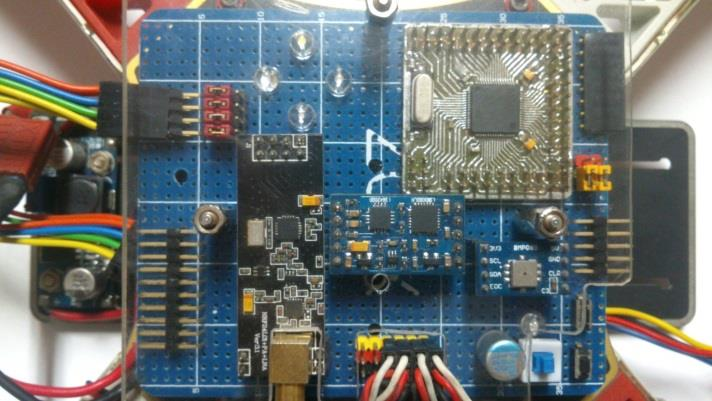
[picture p22: figure]

圖六 飛行控制器實體圖

2.1.7、遙控器
遙控飛行器、給予飛行器指令與監控訊息的裝置。
設有示波器可以檢測飛行器感測器訊息，如圖七所示。
以下為配置：

‧微控制器 STM32F407VGT
ARM 32bit Cortex-M4 CPU with FPU
Frequency up to 168MHz
196Kbytes SRAM，1024bytes Flash

‧無線模組 nRF24L01+PA+LNA
使用 SPI 傳輸( Max 10MHz )
空曠下的理想傳輸距離及速率
520m(2Mbps)/750m(1Mbps)/1000m (250Kbps) ‧顯示器 4.3’ TFT
控制器 SSD1963
解析度 480*272
色彩 16-bit( RGB 565 )

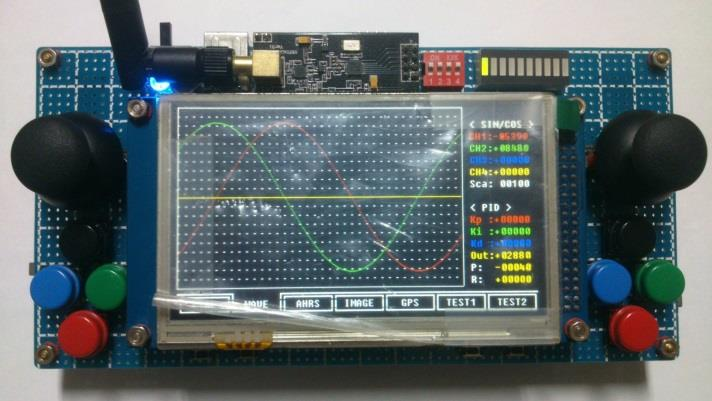
[picture p23: figure]

圖七 遙控器實體圖

2.2、飛行模式
四軸飛行器的飛行模式如圖八所示，當升力等於四
軸飛行器自身重量時，飛行器就會保持懸停狀態；在懸
停狀態下增加或減少相鄰兩邊馬達的旋轉速度，則會使
四軸飛行器傾斜，達到移動；分別增加與減少對角馬達
轉速，則可使飛行器自旋。

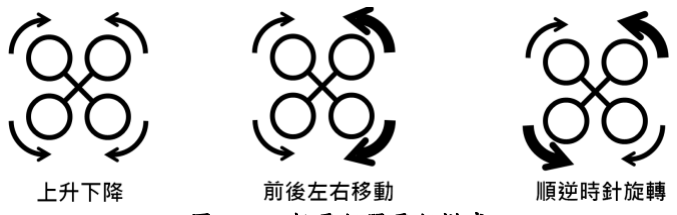
[picture p24: figure]

圖八 四軸飛行器飛行模式

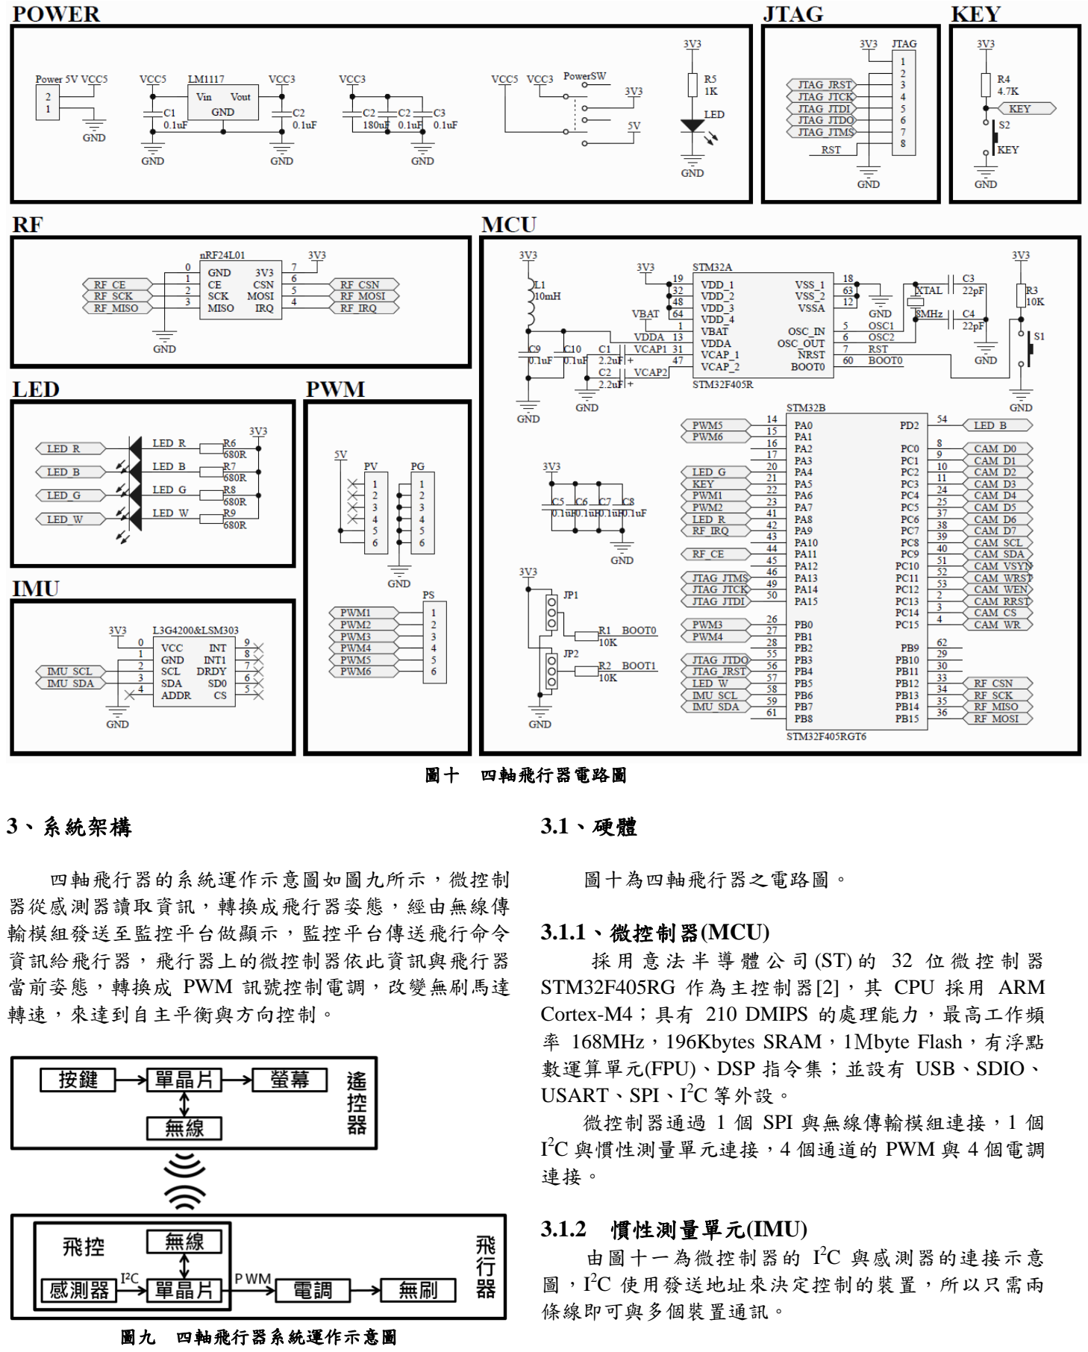
[picture p25: page 3]

圖十 四軸飛行器電路圖

3、系統架構

四軸飛行器的系統運作示意圖如圖九所示，微控制
器從感測器讀取資訊，轉換成飛行器姿態，經由無線傳
輸模組發送至監控平台做顯示，監控平台傳送飛行命令
資訊給飛行器，飛行器上的微控制器依此資訊與飛行器
當前姿態，轉換成 PWM 訊號控制電調，改變無刷馬達 轉速，來達到自主平衡與方向控制。

圖九 四軸飛行器系統運作示意圖

3.1、硬體

圖十為四軸飛行器之電路圖。

3.1.1、微控制器(MCU)
採 用 意 法 半 導 體 公 司 (ST) 的 32 位 微 控 制 器 STM32F405RG 作為主控制器[2]，其 CPU 採用 ARM Cortex-M4；具有 210 DMIPS 的處理能力，最高工作頻 率 168MHz，196Kbytes SRAM，1Ｍbyte Flash，有浮點 數運算單元(FPU)、DSP 指令集；並設有 USB、SDIO、 USART、SPI、I

2C 等外設。
微控制器通過 1 個 SPI 與無線傳輸模組連接，1 個 I

2C 與慣性測量單元連接，4 個通道的 PWM 與 4 個電調 連接。

### 3.1.2 慣性測量單元(IMU)

由圖十一為微控制器的 I

2C 與感測器的連接示意
圖，I

2C 使用發送地址來決定控制的裝置，所以只需兩
條線即可與多個裝置通訊。

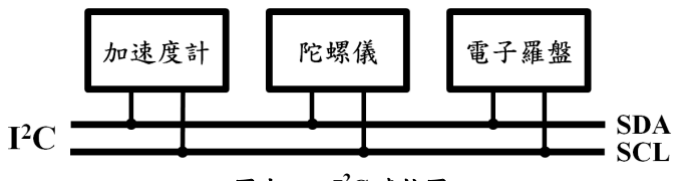
[picture p26: figure]

圖十一 I

2C 連接圖

專題使用 ST 公司的 L3G4200(3 軸陀螺儀)[3]與 LSM303D(3 軸加速度計+3 軸電子羅盤)[4]組成 9 個自由 度(DOF)的 IMU。
L3G4200 與 LSM303D 皆具有 16 位元的解析度，並 且可通過 I

2C 以最高 400kHz 的速率讀取資料。

### 3.1.3 無線傳輸

無線傳輸模組用於向監控平台傳送飛行器上的資訊
與接收控制平台所發送的控制訊號、指令。
本次專題所採用的無線傳輸模組使用 NORDIC 公司 2.4G 的 nRF24L01P[5]，並搭配功率放大器(PA)與低噪 音放大器(LNA)來增加傳輸距離。nRF24L01P 提供了三 種傳輸速率 2Mbps、1Mbps、250Kbps，其空曠下傳輸 距離分別為 520m、750m、1000m。

### 3.1.4 電源

四軸飛行器的電源供應如圖十二所示，由 11.1v
2200mAh 的 鋰 電 池 作 為 電 力 的 來 源 ， 11.1v 經過 LM2596 轉換成 5v，再經由 AMS1117 轉換為 3.3v，其 中 11.1v 供電給電調與無刷馬達，5v 供電給其他設備， 3.3v 供電給飛控板。

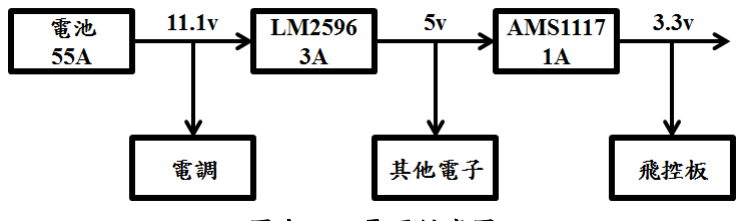
[picture p27: figure]

圖十二 電源供應圖

3.2、軟體
四軸飛行器的程式流程如圖十三所示，供電後系統
首先對系統時脈、I/O 與各種模組及功能做初始化，接 著對感測器做初始校正與飛行器姿態的初始化，然後為
防止馬達突然啟動，設置了鎖定功能，在解鎖前，接收
任何訊號皆不會使馬達旋轉。
解完鎖後即進入有限狀態機(FSM)，狀態機的狀態
如圖十四所示，狀態機的初始狀態為接收模式，在此狀
態中會接收來自控制平台的控制訊號，接收成功後才會
進入到下一個狀態發射模式，在發射模式中會將感測器
讀到的資料與計算的姿態傳送到控制平台，傳送完後就
進入下一個狀態控制模式，在控制模式中會使用平台所
傳來的控制資訊，對四軸飛行器做控制，目前只有控制
飛行器的傾斜角度與馬達轉速大小，控制完後就進入串
列模式，這個狀態是用來測試與外接其他功能用的，以
增加擴充性。


圖十三 程式流程圖

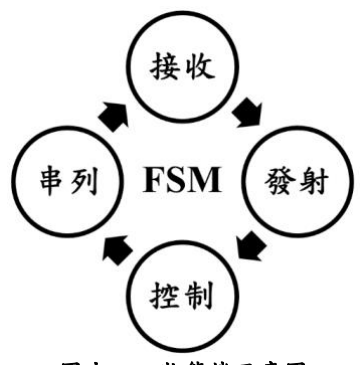
[picture p28: figure]

圖十四 狀態機示意圖

4、演算法

演算法為四軸飛行器之核心，其中主要包含了感測
器的校正、姿態的計算、與平衡的控制，本次專題中主
要的演算法實現於 400Hz 的計時中斷中，其流程如圖十 五所示。
一開始先讀取感測器資料，然後利用初始校正所得
到的校正資訊對讀到的資料作校正，校正完後轉成物理
量(mg、dps、gauss)，再對其做加權移動平均，減少誤 差，最後計算飛行器姿態，並依此當前的姿態做 PID 平 衡，以達到自主懸停及控制。

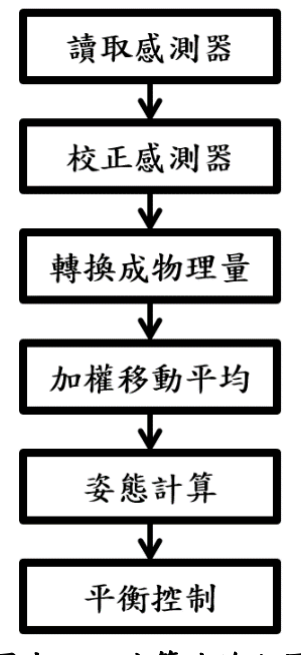
[picture p29: figure]

圖十五 演算法流程圖

### 4.1 初始校正

MEMS 元件雖然具有體積小與低成本的優勢，但只
要是感測器都會有誤差存在的問題。

### 4.1.1 加速度計校正

考慮到地球上相同地區的重力加速度誤差可視為零
的情況下，預先測量在水平狀態下的加速度與重力加速
度 g(0, 0, 1)的誤差並記錄，在程式中就不需再次測量， 直接對加速度計誤差的做偏移校正。

### 4.1.2 陀螺儀校正

陀螺儀為測量角速度的元件，已知靜止無運動的情
況下，角速度為零，利用此條件對陀螺儀做校正，實際
方法：先讓飛行器保持靜止，此時讀取陀螺儀 100 筆數 據求平均值，此平均值則為陀螺儀的誤差偏移量，之後
每次讀取完後減去此平均值即可得到正確的數據。

### 4.1.3 電子羅盤校正

地球磁場並非是均勻分佈的，會存在磁傾角及磁偏
角，以台灣為例，磁傾角約為 37 度左右，加上馬達、 環境、電池…等的影響，在不校正的情況下，難以取的
正確的航向。
只考慮二維的情況下，電子羅盤的 X 軸 Y 軸所讀到 的磁場理想上會以中心在原點上的圓形所分佈，但受到
其他磁場的影響會使圓形變形且偏離原心，造成磁場以
橢圓形分佈。
對電子羅盤間隔 45 度做一次取樣，共有 8 點的磁 場樣本，在對樣本做橢圓擬合[6]，得出橢圓方程後，將 橢圓移到原心，並還原成圓形，使航向可以正常取得。

任意位置大小的橢圓方程式

上式可分解成圓形對 | 軸做變形
對 | 軸做旋轉

求得

將其帶入圓形方程式，可得任意橢圓方程式

使用最小平方法做橢圓擬合, 其中 為取樣數目

欲使 為最小值，必有

展開

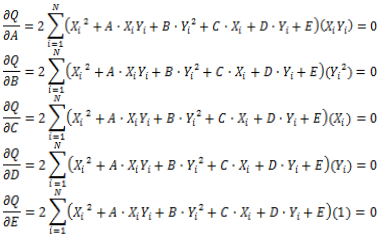
[picture p30: figure]

轉成矩陣形式

解線性方程組後，可得到 | 的值

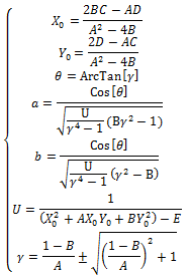
[picture p31: figure]

以上參數所構成的橢圓即為擬合出的橢圓。

### 4.2 姿態計算

直接對角速度做積分是取得姿態的方法之一，但由
於陀螺儀本身的誤差會隨溫度變化，長時間對角速度做
積分等同於放大誤差，加上角速度所計算出來的角度其
中有一為 90 度或 270 度時，轉回原始座標時就會產生 萬向節鎖(Gimbal lock)的問題，導致轉不回去，所以專 題在姿態計算中採用四元數[7]。
在 航 向 角 部 分 則 採 用 互 補 濾 波 (Complementary Filter)，將電子羅盤靜態時精確及陀螺儀的高靈敏度的 特性結合在一起，以取得準確的航向。

### 4.2.1 四元數計算

四元數可以有效解決萬向節鎖問題，且經過一些變
換後，可以直接以角速度來更新姿態與使用加速度計來
校正陀螺儀。

四元數由一個實數與三個虛數組成，可表示成

其中 n 為轉軸方向， | 為轉角大小， | 關係為
設有兩四元數 | ，其乘法關係為

旋轉四元數

設一向量

及旋轉後向量

四元數滿足

四元數倒數

當四元數被歸一化後

可得到

將其展開

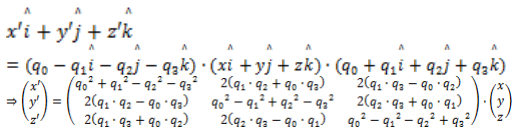
[picture p32: figure]

令四元數旋轉矩陣為

將 | 帶入 | 會得到
將四元數轉成尤拉角，由 | 可得出

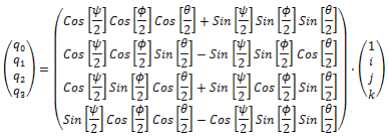
[picture p33: figure]

將四元數對時間微分

已知 | , | , | ，
其中 E 為地理座標系，b 為飛行器坐標系

因為陀螺儀在飛行器上測到的角速度為

故將 | 轉換成 | 會較為方便
將 | 展開

其中

為了簡化程序，對四元數做推廣，使用一階 Runge-Kutta 來更新四元數。

假設有一微分方程

則其解為

其中 為取樣週期，將套用至四元數

展開上式

只需利用角速度即可更新四元數。

### 4.2.2 四元數校正

利用四元數將地理的重力加速度旋轉至飛行器上
面， 再與加速度計讀出的值(已歸一化的)做外積，得出 誤差，用此誤差對角速度做校正融合。

設一重力加速度

對其做歸一化

設旋轉至飛行器上的重力加速度為

飛行器上的加速度計測得的加速度 做歸一化

做外積，計算誤差

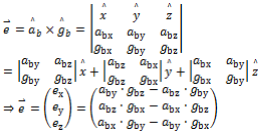
[picture p34: figure]

使用 將 融合至角速度上，達到校正效果。

### 4.2.3 互補濾波

| 將電子羅盤長期準確及陀螺儀靈敏度高的特性互
補，即為對電子羅盤做低通濾波，對陀螺儀做高通濾
波，並將其相加，得出較為可信的資訊。

### 4.3 平衡控制

圖十六為 PID 系統圖，PID 控制器在控制領域上已 有數十年的發展，其特點簡單、穩定、有效使他至今仍
然廣為使用，本專題在自主平衡方面選用 PID 控制器， 輸入期望角度及當前三軸角度至 PID，將計算出來的三 軸 PID 結果，依螺旋槳旋轉的方向分配至四顆馬達上， 來達到對四軸平衡的效果。

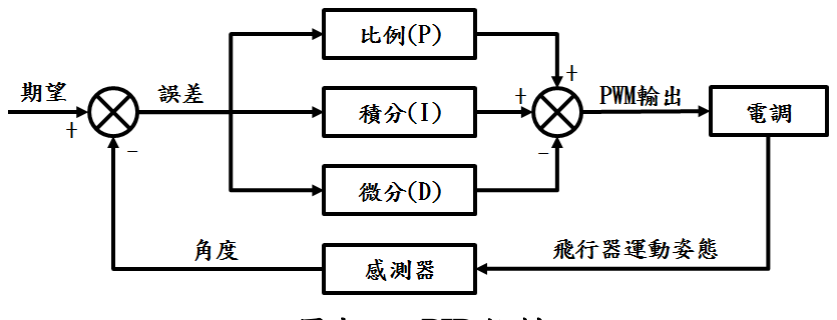
[picture p35: figure]

圖十六 PID 控制

PID 控制器由比例項、積分項、微分項所組成，
在已知 | | 可寫成以下形式，
其中 | 為比例參數，其中 | 為積分與微分時間

將其展開

對上式作離散化

令 | | ，
其中 | 為積分參數， | 為微分參數

目前專題所僅使用 PD 控制器來達到平衡，
其中 < 0

5、結果與討論
以 400Hz 的取樣及更新週期，在沒有啟動馬達的情 況下，姿態角的誤差可以達到 0.2 度內，在起動馬達 後，誤差則會變成在 5 度內，使用 PID 雖然可以讓飛行 器飛起來，但卻沒辦法非常穩定的平衡，所以目前設計
的計算姿態方法還需再調整及改善，以達到穩定的平
衡，圖十七至圖二十四為起飛時每隔 0.2 秒所拍攝的八 個影像。
圖二十五為加速度的整體數據，縱軸單位為加速度
(mg)，橫軸單位為數據數，啟動馬達後加速度計的 XY 軸約在±0.3g 跳動，而 Z 軸約±0.2g 跳動。 圖二十六為陀螺儀的整體數據，縱軸單位為角速度
(10mdps)，橫軸單位為數據數，啟動馬達後陀螺儀的 X 軸約±40dps 跳動，Y 軸約±100dps 跳動，而 Z 軸約 ±10dps 跳動。
圖二十七為電子羅盤的整體數據，縱軸單位為高斯
(0.1mGauss)，橫軸單位為數據數，啟動馬達後電子羅盤 震動都還不算太大，但出現了明顯的磁場變化，X 軸約
減少了 20mGauss，Y 軸約減少了 60mGauss，而 Z 軸約 減少了 70mGauss。
圖二十八為計算出來的角度數據，縱軸單位為角度
(XY 軸 10mdeg，Z 軸 100mdeg)，橫軸單位為數據數， 啟動馬達後角度的 X 軸約±4deg 跳動，Y 軸約±2deg 跳 動，而 Z 軸幾乎沒有明顯震動，反倒是偏移了 10deg。

6、參考文獻

[1] 維基百科 Wiki_多軸飛行器
http://zh.wikipedia.org/wiki/%E5%A4%9A%E8%BB%B8 %E9%A3%9B%E8%A1%8C%E5%99%A8 (http://zh.wikipedia.org/wiki/%E5%A4%9A%E8%BB%B8%E9%A3%9B%E8%A1%8C%E5%99%A8)
[2] STM32F405RGT datasheet http://www.st.com/web/catalog/mmc/FM141/SC1169/SS1577/LN1035/PF252144 (http://www.st.com/web/catalog/mmc/FM141/SC1169/SS1577/LN1035/PF252144)
[3] L3G4200 datasheet
http://www.st.com/web/catalog/sense_power/FM89/SC1288/PF250373?s_searchtype=partnumber (http://www.st.com/web/catalog/sense_power/FM89/SC1288/PF250373?s_searchtype=partnumber)
[4] LSM303D datasheet
http://www.st.com/web/catalog/sense_power/FM89/SC1449/PF251902?s_searchtype=partnumber (http://www.st.com/web/catalog/sense_power/FM89/SC1449/PF251902?s_searchtype=partnumber)
[5] nRF24L01P datasheet
http://www.nordicsemi.com/eng/Products/2.4GHz-RF/nRF24L01P (http://www.nordicsemi.com/eng/Products/2.4GHz-RF/nRF24L01P)
[6] 陳基偉, ”橢圓直接擬合算法研究”, 工程勘察, 2007
[7] 鄭正隆, ”慣性技術 Inertial Technology”, 崧博出版事 業有限公司, 2011

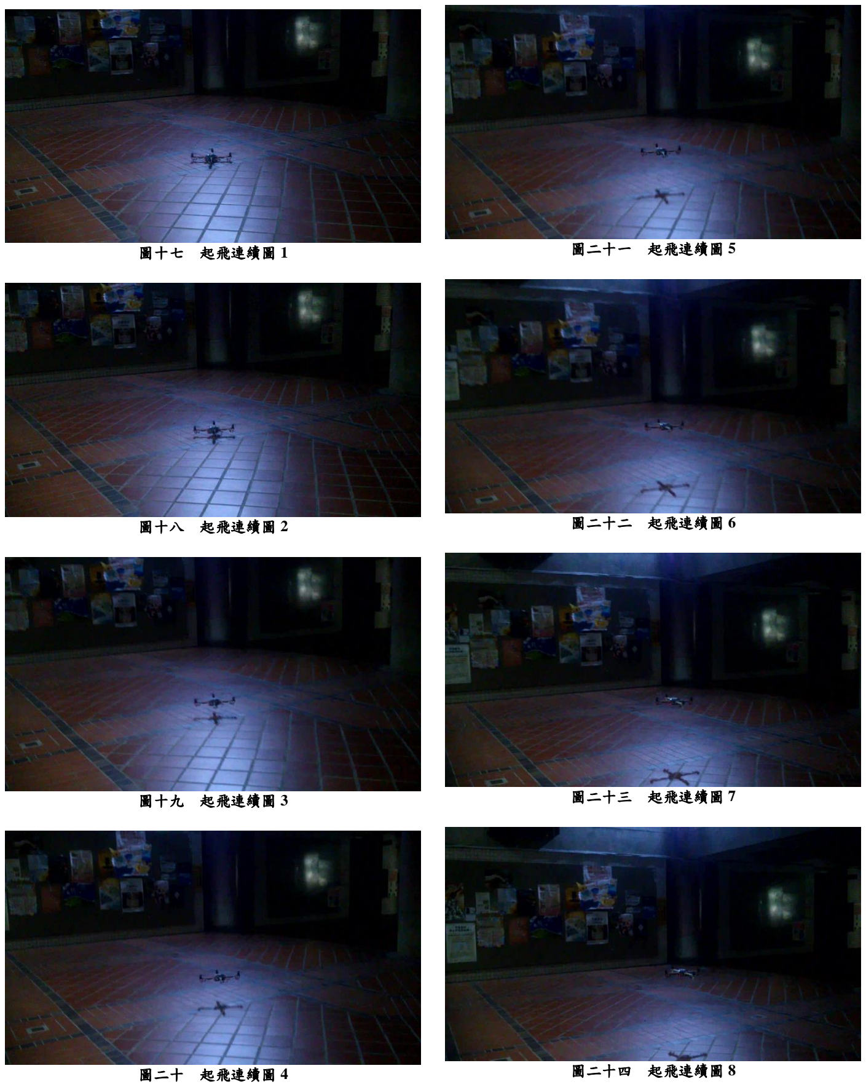
[picture p36: page 9]

圖十七 起飛連續圖 1

圖十八 起飛連續圖 2

圖十九 起飛連續圖 3

圖二十 起飛連續圖 4

圖二十一 起飛連續圖 5

圖二十二 起飛連續圖 6

圖二十三 起飛連續圖 7

圖二十四 起飛連續圖 8

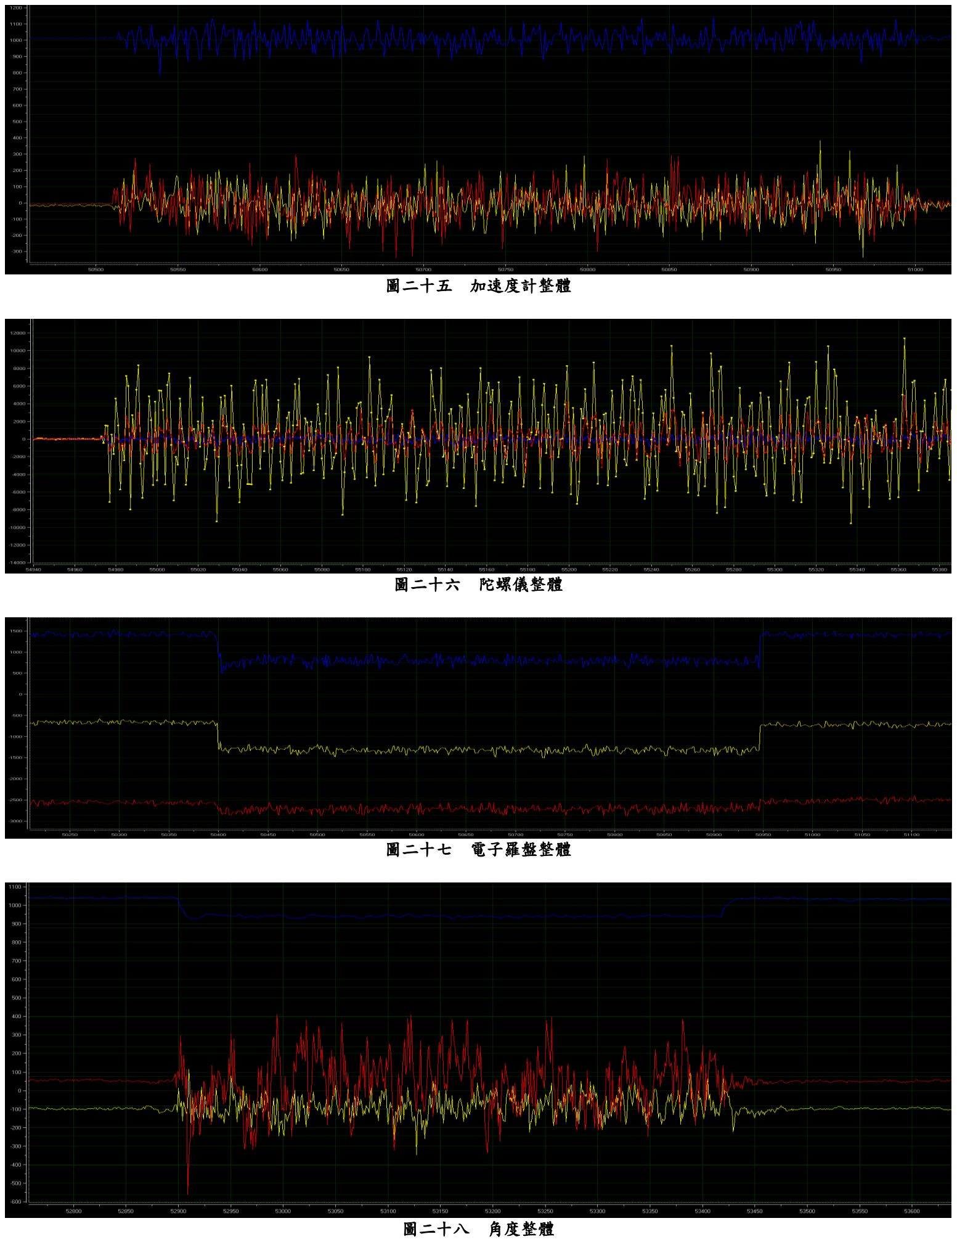
[picture p37: page 10]

圖二十五 加速度計整體

圖二十六 陀螺儀整體

圖二十七 電子羅盤整體

圖二十八 角度整體
