Hom-Wang/Quadcopter/推導_PID控制器.pdf

## PID 控制器 中原大學 CYPH 王文宏

PID 控制器由比例 Proportional、積分 Integral、微分 Derivative 所組成

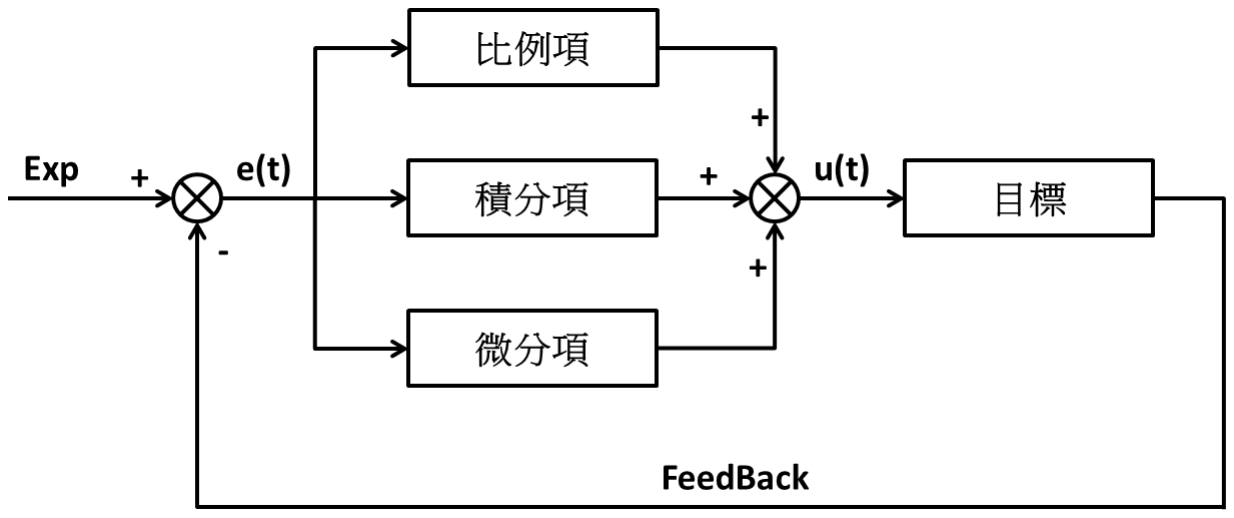
[picture p38: figure]

在已知 e(t) = Exp − Feedback 可寫成以下形式，其中 KP 為比例參數

u(t) = KP[e(t) +

1
TI

∫ e(t) ⅆt

t

0

+ TD

ⅆe(t)
ⅆt

]

將其展開，其中 TI

, TD 為積分時間與微分時間

u(t) = KPe(t) +

KP
TI

∫ e(t) ⅆt

t

0

+ KPTD

ⅆe(t)
ⅆt

對上式作離散化

u(t) = KPe(t) +

KP
TI

∑e(t)Δt

t

t=0

+ KPTD

e(t) − e(t − 1)
Δt

⇒ u(t) = KPe(t) +

KPΔt
TI

∑e(t)

t

t=0

+

KPTD
Δt

(e(t) − e(t − 1))

令 KI =

KPΔt
TI

, KD =

KPTD
Δt

, 可到到位置式 PID, 其中 KI 為積分參數, KD 為微分參數

u(t) = KPe(t) + KI ∑e(t)

t

t=0

+ KD(e(t) − e(t − 1))

由 Δu(t) = u(t) − u(t − 1) 可得到增量式 PID

Δu(t) = KP(e(t) − e(t − 1)) + KIe(t) + KD(e(t) − 2e(t − 1) + e(t − 2))

增量式 PID 與位置式 PID 之關係為

u(t) = ∑Δu(t)

t

t=0
