Hom-Wang/Quadcopter/推導_橢圓擬合.pdf

## 橢圓擬合 中原大學 CYPH 王文宏

任意位置大小的橢圓方程式
(

X − X0
a

)

2
+ (

Y − Y0
b

)

2
= 1

上式可分解成圓形對 X, Y 軸做變形
{

(

X − X0
Y − Y0

) = (

a 0
0 b

) (

X′
Y′

)

(X′)

2 + (Y′)

2 = 1

對 X, Y 軸做旋轉
{
(

X − X0
Y − Y0

) = (

Cos[θ] Sin[θ]
−Sin[θ] Cos[θ]

) (

a 0
0 b

) (

X′
Y′

)

(X′)

2 + (Y′)

| 2 = 1

求得 X

′
, Y′
(

X

′
Y

′

) = (

aCos[θ] bSin[θ]
−aSin[θ] bCos[θ]

)

| −1
(

X − X0
Y − Y0

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
Cos[θ]
a

−

Cos[θ]
a

·

Sin[θ]
Cos[θ]
Cos[θ]
b

·

Sin[θ]
Cos[θ]

Cos[θ]
b | )

(

X − X0
Y − Y0

)

令 α =

Cos[θ]
a

, β =

Cos[θ]
b

, γ = Tan[θ]

⟹ (

X

′
Y

′

) = (

α | −α · γ
β · γ | β

) (

X − X0
Y − Y0

) = (

α(X − X0

) − αγ(Y − Y0)
βγ(X − X0

) + β(Y − Y0)

)

代入圓形方程&整理

(α(X − X0

) − αγ(Y − Y0))

2 + (βγ(X − X0
) + β(Y − Y0))

2 = 1
⟹ (α

2 + β

2γ

2
)(X − X0

)

2 + 2(β

2γ − α

2γ)(X − X0
)(Y − Y0

) + (α

2γ

2 + β

2
)(Y − Y0

)

2 = 1

令 U = α

2 + β

2γ

2
, V = 2(β

2γ − α

2γ), W = α

2γ

2 + β

2

(U)X

2 + (V)XY + (W)Y

2 + (−2UX0 − VY0
)X + (−VX0 − 2WY0

)Y + (UX0

2 + VX0Y0 + WY0

2
) = 1

⟹ X

2 + (

V
U

) XY + (

W
U

) Y

2 + (

−2UX0 − VY0
U

) X + (

−VX0 − 2WY0
U

) Y + (
UX0

2 + VX0Y0 + WY0

2
U

) = 1

⟹ X

2 + (

V
U

) XY + (

W
U

) Y

2 + (−2X0 −

V
U

Y0) X + (−

V
U

X0 − 2

W
U

Y0) Y + (X0
2 +

V
U

X0Y0 +

W
U

Y0

2

) =

1
U

任意橢圓方程式

X

2 + A · XY + B · Y

2 + C · X + D · Y + E = 0

其中 A =

V
U

, B =

W
U

, C = −2X0 − AY0, D = −AX0 − 2BY0, E = X0

2 + AX0Y0 + BY0

2 −

1
U

⟹ X

2 + AXY + BY

2 + (−2X0 − AY0
)X + (−AX0 − 2BY0

)Y + (X0
2 + AX0Y0 + BY0

2 −

1
U

) = 0

使用最小平方法做橢圓擬合, 其中 N 為取樣數目

Q = ∑Fi
2

N

i=1

= ∑(Xi
2 + A · XiYi + B · Yi

2 + C · Xi + D · Yi + E)
2

N

i=1

欲使 Q 為最小值, 必有

∂Q
∂A =

∂Q
∂B =

∂Q
∂C =

∂Q
∂D =

∂Q
∂E = 0

展開

∂Q
∂A = 2∑(Xi
2 + A · XiYi + B · Yi

2 + C · Xi + D · Yi + E)(XiYi )

N

i=1

= 0

∂Q
∂B

= 2∑(Xi
2 + A · XiYi + B · Yi

2 + C · Xi + D · Yi + E)(Yi

2
)

N

i=1

= 0

∂Q
∂C

= 2∑(Xi
2 + A · XiYi + B · Yi

2 + C · Xi + D · Yi + E)(Xi) = 0

N

i=1
∂Q
∂D

= 2∑(Xi
2 + A · XiYi + B · Yi

2 + C · Xi + D · Yi + E)(Yi)

N

i=1

= 0

∂Q
∂E

= 2∑(Xi
2 + A · XiYi + B · Yi

2 + C · Xi + D · Yi + E)(1) = 0

N

i=1

矩陣形式

(

∑Xi
2Yi

2

N

i=1

∑XiYi
3

N

i=1

∑Xi
2Yi

N

i=1

∑XiYi
2

N

i=1

∑XiYi

N

i=1
∑XiYi
3

N

i=1

∑Yi
4

N

i=1

∑XiYi
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
∑XiYi
2

N

i=1

∑Xi
2

N

i=1

∑XiYi

N

i=1

∑Xi

N

i=1
∑XiYi
2

N

i=1

∑Yi
3

N

i=1

∑XiYi

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
∑XiYi

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
i=1 | )

解線性方程組後, 可得到 A, B, C,D, E 的值

由 C = −2X0 − AY0, D = −AX0 − 2BY0 , 可解得 X0, Y0

X0 =

2BC − AD
A² − 4B

, Y0 =

2D − AC
A² − 4B

由 U = α

2 + β

2γ

2
, V = 2(β

2γ − α

2γ), W = α

2γ

2 + β | 2 , 可解得 γ, θ

W − U
V

=

| 1 − γ
| 2 2γ

⟹ Vγ² + 2(W − U)γ − V = 0
⟹ Aγ

2 + 2(B − 1)γ − A = 0

γ =

1 − B
A

± √(
1 − B
A

)

2 + 1

θ = ArcTan[γ]

由 E = X0

2 + AX0Y0 + BY0

2 −

1
U

, 可解得 U

U =

1
(X0

2 + AX0Y0 + BY0

2
) − E

由 U = α

2 + β

2γ

2
, V = 2(β

2γ − α

2γ) , 可解得 a, b

α = √
U
γ

4 − 1

(Bγ

2 − 1), β = √
U
| γ

4 − 1

(γ

2 − B)

⟹ a =

Cos[θ]
α

, b = Cos[θ]
β

整理結果

{

X0 =

2BC − AD
A² − 4B

Y0 =

2D − AC
A² − 4B
θ = ArcTan[γ]

a =

Cos[θ]
√
U
γ

4 − 1

(Bγ

2 − 1)

b =

Cos[θ]
√
U
γ

4 − 1

(γ

2 − B)

U =

1
(X0

2 + AX0Y0 + BY0

2
) − E

γ =

1 − B
A

± √(
1 − B
A

)

2
+ 1

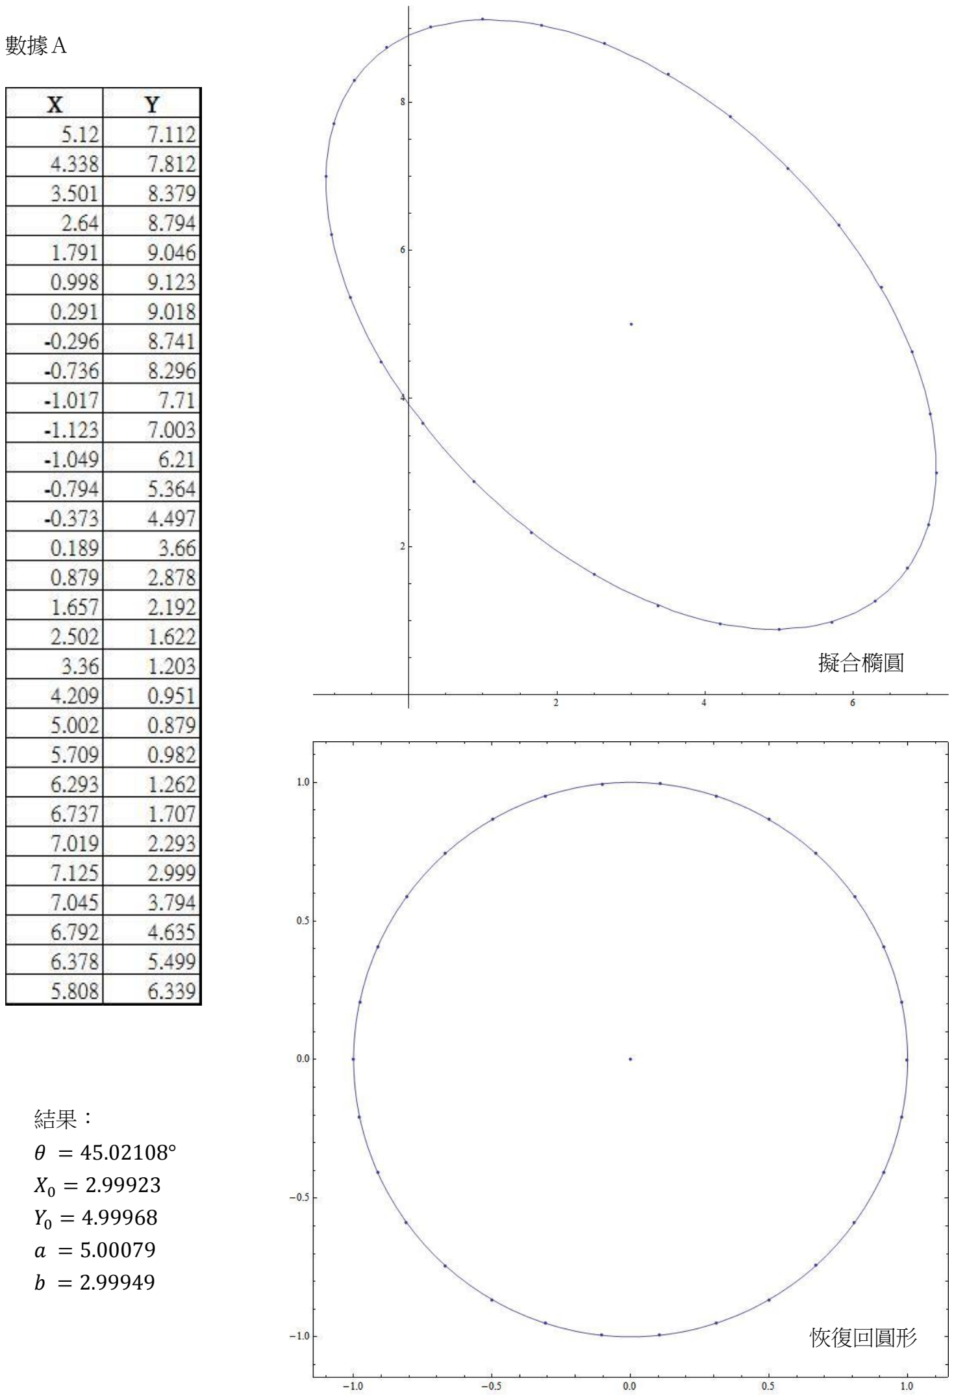
[picture p39: page 4]

數據Ａ

θ = 45.02108°
X0 = 2.99923
Y0 = 4.99968
a = 5.00079
b = 2.99949

結果：

擬合橢圓

恢復回圓形

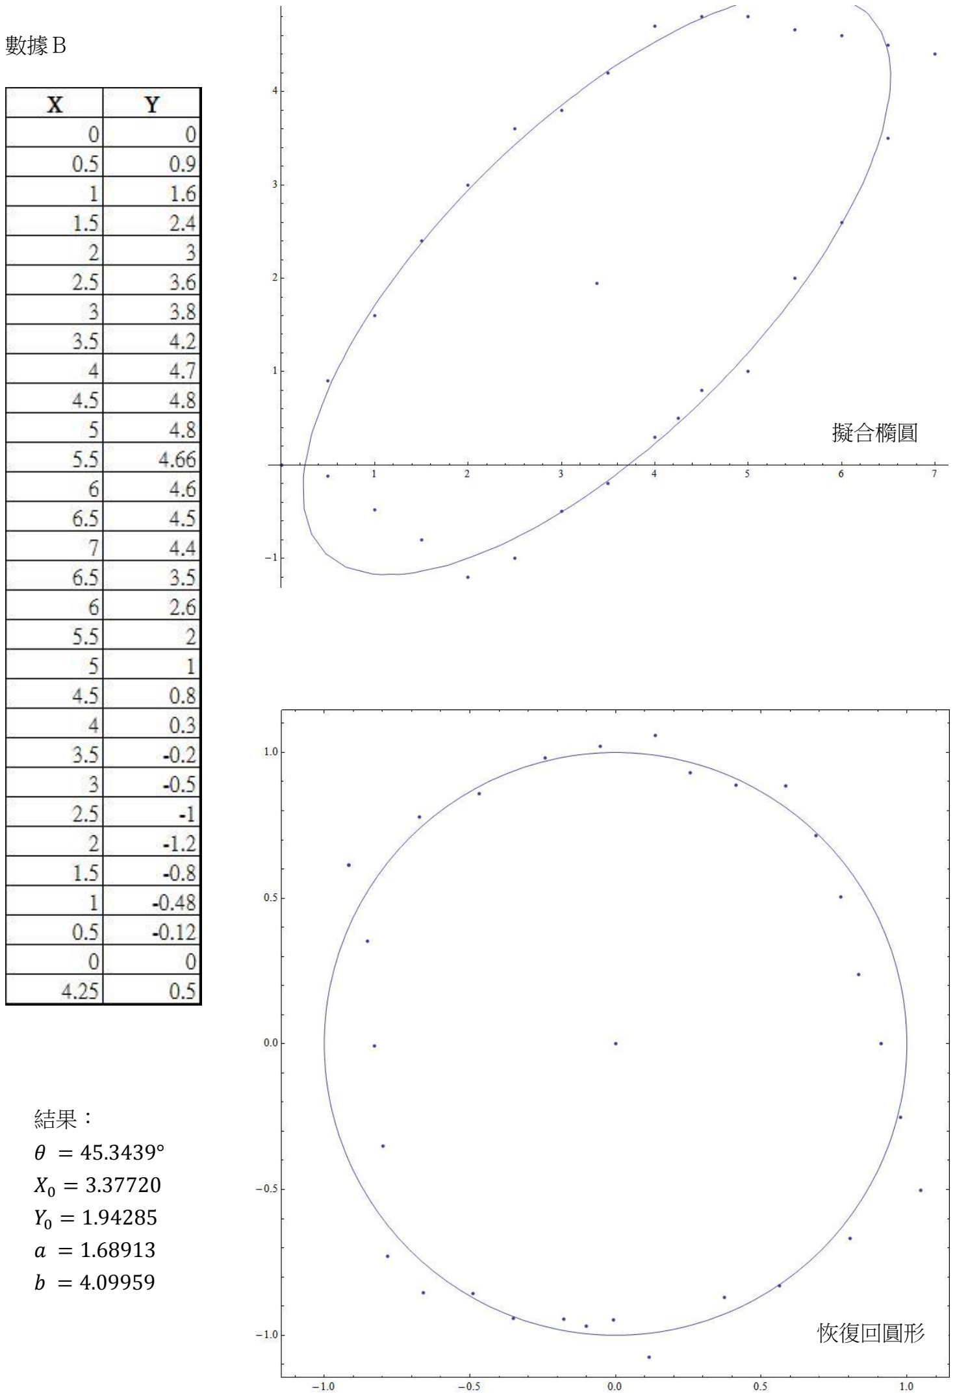
[picture p40: page 5]

數據Ｂ

θ = 45.3439°
X0 = 3.37720
Y0 = 1.94285
a = 1.68913
b = 4.09959

結果：

擬合橢圓

恢復回圓形

擬合橢圓

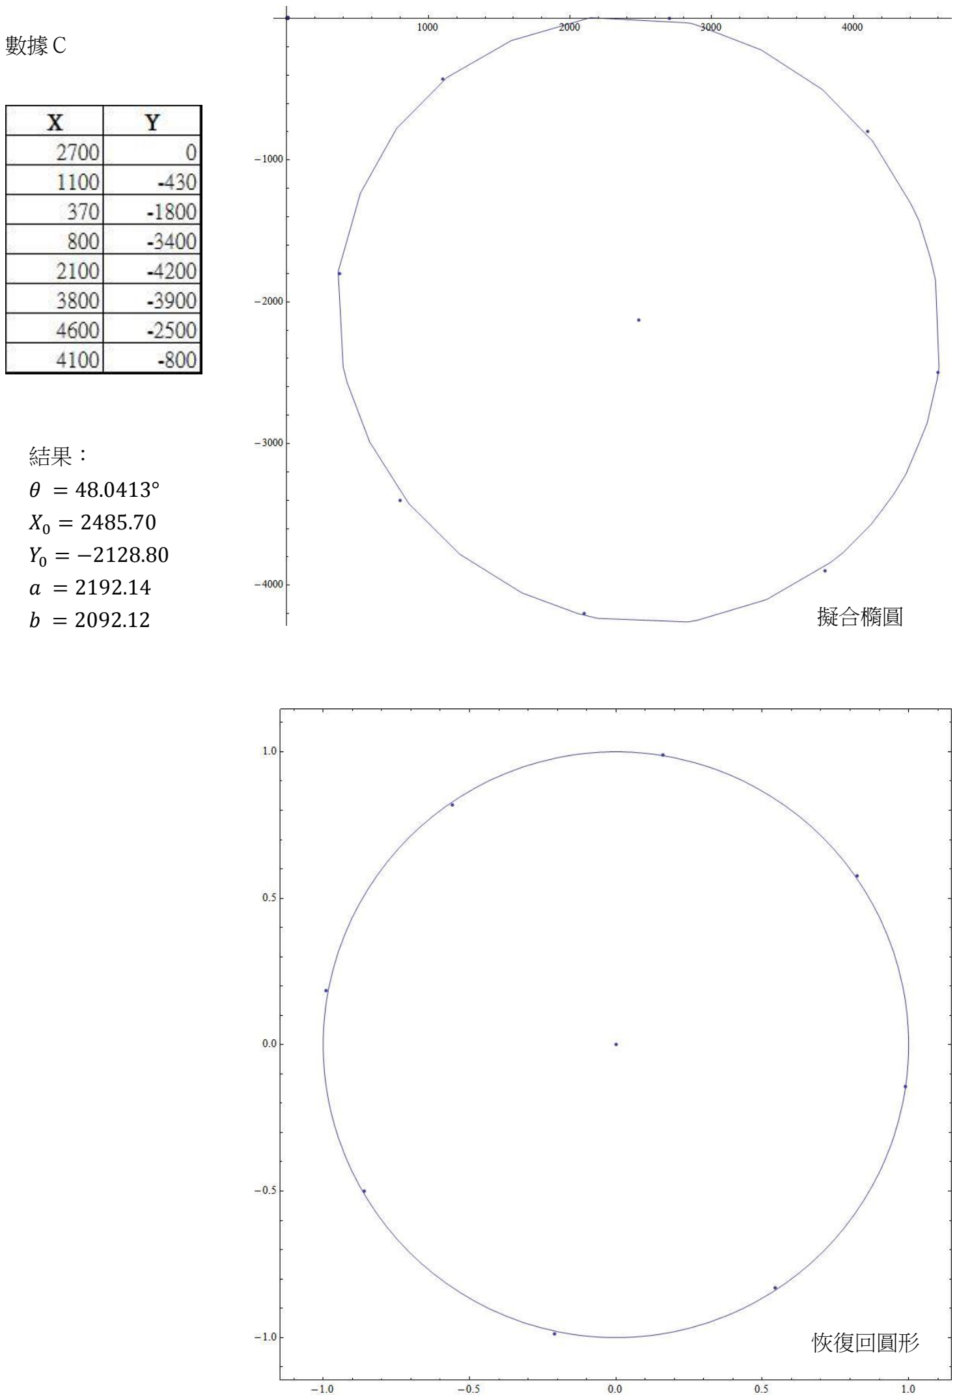
[picture p41: page 6]

數據Ｃ

θ = 48.0413°
X0 = 2485.70
Y0 = −2128.80
a = 2192.14
b = 2092.12

結果：

擬合橢圓

恢復回圓形

擬合橢圓
