Hom-Wang/Quadcopter/STM32F4_QCopter_20130617/Program_Master/module_fontlib.h

/* #include "module_fontlib.h" */

#ifndef __MODULE_FONTLIB_H
#define __MODULE_FONTLIB_H

#include "stm32f4xx.h"
/*=====================================================================================================*/
/*=====================================================================================================*/
/*
const unsigned char  ASCII_12x6 [95][12]
const unsigned char  ASCII_16x8_[95][16]
const unsigned char  ASCII_16x8 [95][16]
*/

const unsigned char ASCII_12x6[95][12] = {
	{0x00,0x00,0x00,0x00,0x00,0x00,0x00,0x00,0x00,0x00,0x00,0x00},	/* " " 032 */
	{0x00,0x00,0x04,0x04,0x04,0x04,0x04,0x04,0x00,0x04,0x00,0x00},	/* "!" 033 */
	{0x00,0x14,0x0A,0x0A,0x00,0x00,0x00,0x00,0x00,0x00,0x00,0x00},	/* """ 034 */
	{0x00,0x00,0x14,0x14,0x3F,0x14,0x0A,0x3F,0x0A,0x0A,0x00,0x00},	/* "#" 035 */
	{0x00,0x04,0x1E,0x15,0x05,0x06,0x0C,0x14,0x15,0x0F,0x04,0x00},	/* "$" 036 */
	{0x00,0x00,0x12,0x15,0x0D,0x0A,0x14,0x2C,0x2A,0x12,0x00,0x00},	/* "%" 037 */
	{0x00,0x00,0x04,0x0A,0x0A,0x1E,0x15,0x15,0x09,0x36,0x00,0x00},	/* "&" 038 */
	{0x00,0x02,0x02,0x01,0x00,0x00,0x00,0x00,0x00,0x00,0x00,0x00},	/* "'" 039 */
	{0x00,0x20,0x10,0x08,0x08,0x08,0x08,0x08,0x08,0x10,0x20,0x00},	/* "(" 040 */
	{0x00,0x02,0x04,0x08,0x08,0x08,0x08,0x08,0x08,0x04,0x02,0x00},	/* ")" 041 */
	{0x00,0x00,0x00,0x04,0x15,0x0E,0x0E,0x15,0x04,0x00,0x00,0x00},	/* "*" 042 */
	{0x00,0x00,0x04,0x04,0x04,0x1F,0x04,0x04,0x04,0x00,0x00,0x00},	/* "+" 043 */
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
    0x1c, 0x22, 0x42, 0x40, 0x4e, 0x42, 0x22, 0x1c,
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
};
/*=====================================================================================================*/
/*=====================================================================================================*/
#endif
