Hom-Wang/Quadcopter/STM32F4_QCopter_20130617/Program_Master/module_rs232.h

/* #include "module_rs232.h" */

#ifndef __MODULE_RS232_H
#define __MODULE_RS232_H

#include "stm32f4xx.h"
/*=====================================================================================================*/
/*=====================================================================================================*/
void RS232_Config( void );
void RS232_VisualScope( USART_TypeDef*, u8*, u16 );
/*=====================================================================================================*/
/*=====================================================================================================*/
#endif
