Hom-Wang/Quadcopter/(notices)

Notices in the files:
Readme.md:
CC BY-SA 3.0
